PEPpuig/LSE/entregas/Controlador_BLDC_PepPuig_JordiGodas.docx

# CONTROLADOR BLDC

INDEX

1.INTRODUCCIÓ

A diferència dels motors DC tradicionals, on la commutació del corrent als bobinats del rotor es realitza mecànicament mitjançant escombretes, els motors BLDC (Brushless DC) estan formats per imants permanents al rotor, mentre que el bobinat es col·loca a l’estator distribuïts a 120º per un control trifàsic. Treure el component mecànic dels motors DC amb escombretes comporta una varietat d’avantatges:

- Una millor conversió d’energia. Passant d’una eficiència del 70-80% amb escombretes, a un 85-93%, degut a l’absència de fregament mecànic ens estalviem moltes de les pèrdues en calor.
- Millor durabilitat. Degut a la inexistència de desgast dels contactes mecànics, s’estén la vida útil del motor arribant a ser de 10 a 20 vegades més llarga.
- Reducció del soroll. Podent arribar a per sota de 50 decibels, 10 o 20 per sota dels altres.

Tot i això no tot són avantatges, ja que totes aquestes característiques venen al preu de major complexitat i preu, degut al necessari controlador de potència per a manegar el seu ús.

Per a controlar el BLDC es necessària l’etapa de potència coneguda com a inversor de 3 semi ponts, organitzat per 6 MOSFETs de potència en 3 branques diferents que permeten subministrar el corrent demanat pel motor ràpidament. Aquest muntatge té una sèrie de punts a favor i encontra:

Avantatges:

- Permet controlar de manera independent i reversible la direcció del corrent a cada bobina de l’estator.
- És possible la regulació de la velocitat i força del motor mitjançant PWM.
- Facilita la circulació del corrent en els períodes en OFF a través dels díodes de recirculació dels MOSFETs.
- La mateixa estructura permet diversos controls per software, ja sigui per controls senzill com trapezoidal, o més avançats com el FOC.

Inconvenients:

- Si per error de programació o retard de commutació dos dels transistor en un mateix semi pont s’activen a la vegada, es produeix un curtcircuit (Shoot–through) entre VCC i GND que pot destruir els MOSFETs. És important implementar un temps mort en la senyal de control per evitar que això pugui succeir.
- Els transistors superiors (High-side) necessiten una tensió de porta més alta que la de la alimentació (VCC) per commutar, el que ens obliga a implementar un circuit de bootstrap, incrementant la complexitat del circuit.
- La commutació (PWM) d’alta freqüència de les portes produeix soroll que pot propagar-se cap a altres parts del circuit. És necessari un bon esquemàtic de la PCB que tingui aquest efecte en compte, o la placa no serà funcional.

Com ja hem mencionat en els avantatges, podem excitar el circuit de 6 semiponts de diferents formes, sempre augmentant la complexitat per aconseguir un millor resultat.

Excitació trapezoidal:

És el mètode més senzill. En cada una dels 6 passos del cicle elèctric només s’activen dues fases mentre la tercera queda flotant. Aquesta fase flotant ens serveix per mesurar la BEMF i detectar el pas per zero per saber quan cal fer el següent pas.

Sinusoidal:

A diferencia de l’anterior, en comptes d’injectar corrent continu per blocs, els tres semi ponts commuten mitjançant un PWM per simular 3 sinusoidals desfasades 120º. Aquest mètode permet un moviment molt més suaus, eliminant les vibracions entre passos del mètode anterior. A canvi, la complexitat dels càlculs dificulta el seguiment de l’ona.

Field Oriented Control (FOC):

En aquest sistema es calcula la posició exacta de l’imant a cada instant, i es divideix el corrent en dos components independents, una que fa girar el motor ( I_q ) i un altre que genera calor ( I_d ). S’intenta ajustar el sistema en temps real de tal forma que I_d sigui 0, i Iq depengui de la velocitat que li volem donar. D’aquesta manera sempre s’aplica l’angle d’eficiència màxima fins i tot a baixes velocitats.

Degut a que disposem d’un motor sense sensor, es necessàri detectar la força contra electromotriu per deduir la posició del rotor. Per fer-ho podem usar diferents tècniques:

- Detecció de creuament per zero. Si usem la topologia trapezoidal, s’usa la fase que queda flotant per trobar el punt on BEMF passa a 0, en aquest punt és on hem de realitzar el canvi de fase. Per fer això possible, és necessari crear un node neutre virtual ja que el punt neutre real és inaccessible dintre del motor. Si no es dimensiona correctament el filtre passa-baix, el motor pot no arrencar.
- Mesura diferencial amb ADC. És mostreja la fase flotant amb un canal ADC sincronitzat amb els períodes ON i OFF del PWM, realitzant la comparació amb el neutre.
- Integració de BEMF. S’integra en el temps el senyal BEMF per determinar el flux magnètic acumulat. Requereix d’una capacitat de càlcul superior, a canvi d’una major immunitat al soroll.

Després de la introducció tecnològica descrita anteriorment, l’objectiu principal d’aquest projecte és la implementació en PCB i la programació d’un controlador electrònic de velocitat (ESC) sense sensors per a un motor BLDC. Per aconseguir l’èxit en aquesta tasca dividirem el projecte en diferents objectius més petits i específics:

Simulació:

- Correcte funcionament del model funcional del motor (BLDC) ajuntant les equacions del domini elèctric i mecànic.
- Analitzar el comportament del driver de potència IR2301SPBF, dels transistors MOSFET en configuració trifàsica, i el dimensionament del condensador de bootstrap.
- Simular el circuit de recuperació del senyal BEMF per tal de comparar-la amb l’original i observar l’absència de retards.

Disseny de la PCB

- Disseny correcte de l’esquemàtic estructurat amb blocs per funcionalitat.
- Layout de 4 capes separant les diferents parts de potència i lògica, assegurant el correcte funcionament quan s’imprimeixi.

Programació de la TIVA-C

- Programació dels PWM a 20kHz i la màquina d’estats de commutació de 6 estats.
- Implementar algoritme d’arrancada per vèncer la inèrcia inicial del motor.
- Programa per detectar el creuament de BEMF per zero i fer el funcionament del motor en close loop.

# 2. SIMULACIONS LTSPICE OPEN-LOOP

## 2.1 Model motor


Figura 1- Esquemàtic del model funcional del motor

El model funcional del motor és divideix en quatre segments, sent la primera d’elles el domini elèctric. En aquesta secció es modela la connexió en estrella de les tres fases (FASE_x) convergint en el node neutre, on cada branca inclou la inductància del bobinat (Lm), les pèrdues resistives associades ( R_m ) i la força de tensió contraelectromotriu ( V_(BEMF_x) ) representada com una font de tensió controlada en sèrie. Les 3 fases (A, B i C) provindran dels drivers (fora del model del motor) i la definició de les forces electromotrius, del subcircuit BEMF. Aquesta secció ens serveix per trobar el corrent de cada fase i així poder calcular la potència elèctrica que es transfereix a la part mecànica.

El següent apartat és la conversió de domini elèctric a mecànic, on és calcula en cada instant la potència elèctrica instantània. Per calcular-la sumem el resultat de la potència individual de les tres fases, la qual és igual a la força BEMF de cada fase referència al neutral multiplicada per la corrent corresponent. A partir de la igualtat entre la potència elèctrica i mecànica i utilitzant la freqüència angular, podem obtenir la força o parell mecànic del motor ( T_(motor) ).

P_(electrica_inst) =P_(mecànica) =T_(motor) *w →T_(motor) =(P_(electrica_(inst)))/w

La tercera secció és el domini mecànic on directament s’aplica la 2a llei de Newton per a un sistema rotatori:

T_(motor) -T_(load) =J*(dw)/(dt)+B*w → w=1/J(∫ (T_(motor) -T_(load) )dt-B∫ w*dt)

On T_(load) és la força externa que s’oposa al gir del motor; J és el moment d’inèrcia ( 10^(-6) kg*m^2 ) i B el coeficient de fricció viscos (2*10^(-3) (N*m*s)/(rad)) .

Mitjançat blocs integradors multiplicador podem aïllar la velocitat angular a través de la força del motor que hem trobat a l’apartat anterior. Fent el factor de conversió adequat podem passar rad/s a rpm per fer-nos una millor idea de la velocitat del motor. En aquest apartat també calculem l’angle total del gir del motor (theta_t) i la posició angular en una revolució, és a dir, de 0 a 2 π ; el primer integrant la velocitat angular en el temps i el segon mitjançant la funció següent en una font de tensió depenent:

V_(theta) ={(V_(theta_t))/(2π)-floor((V_(theta_t))/(2π))}*2π

La primera part de la funció ( (V_(theta_t))/(2π) ) calcula les voltes totals, i en restar-li la funció floor de la mateixa part, la cual retorna el nombre enter més proper, trobem la fracció de volta actual. Finalment al multiplicar per 2π ho passem a radians, i trobem l’angle actual del motor.

La última secció és la conversió de domini mecànic a elèctric, on usem la velocitat angular i l’angle total del motor per calcular les forces contraelectromotrius de cada branca ( V_(BEMF_x) ) i la tensió del neutre. Concretament l’angle total el multipliquem per 6 abans d’entrar al subcircuit BEMF degut a que 6 cicles elèctrics equivalen a una rotació sencera del motor. Amb aquests dos paràmetres dintre del subcircuit definim 3 donts de tensió dependents que definiran les BEMFs, generant senyals sinusoidals desfasades 120º amb amplitud KT * w.

V_(BEMF_x) =K_T *w*sin(θ_t +(2π)/3*i)

On i és 0 per la fase A, 1 per la B, i 2 per la C; K_T (constant de parell) expressa la força que produeix el motor per cada amper de corrent = 15*10^(-3) (N*m)/A

Per calcular els senyals de sensor hall (HALL_x)s’avalua la diferència de tensió entre fases mitjançant funcions if, donant 5V quan és positiva i 0 quan negativa.

## 2.2 Llaç obert

Per fer girar el motor l'alimentem amb tres fases desfasades 120º, generades per un inversor de tres semi ponts. L'esquemàtic complet de la simulació es pot veure a la Figura 2. El mòdul de generació de senyals crea les entrades dels drivers (HxI per al MOSFET alt i LxI per al baix de cada fase), on l'entrada alta es multiplica per un PWM de 20 kHz que ens permet regular la velocitat. Els drivers LTC4446, amb el seu circuit de bootstrap, exciten els MOSFETs IRFHM830D que alimenten el model del motor de l'apartat anterior. Fem servir els valors de l'exemple del curs: durada de fase de 1,2 ms, duty de 0,6, VCC = 10 V i parell de càrrega de 10 mN·m.


Figura 2- Esquemàtic que afegim al model del motor per simular el llaç obert


Figura 3a i 3b- Entrades (hxi i lxi) i sortides (fase_x) dels drivers per les 3 fases – Zoom de les entrades i sortides del driver de la fase A

A les Figures 3a i 3b podem veure el desfasament de 120º entre els senyals de control i la presència del PWM a l'entrada alta de cada driver. A la sortida es conserva aquest desfasament: cada fase està connectada a VCC amb el PWM durant dos estats, a massa durant dos més i queda flotant els dos restants, que és on apareix la BEMF que farem servir per detectar la posició del rotor.

La tensió del node neutre segueix el PWM i oscil·la entre 0 i uns 6,8 V a 20 kHz (Figura 10, a la secció 2.3, on es compara amb el neutre virtual). Aquest soroll és el que haurem de filtrar per poder comparar la BEMF amb el neutre.

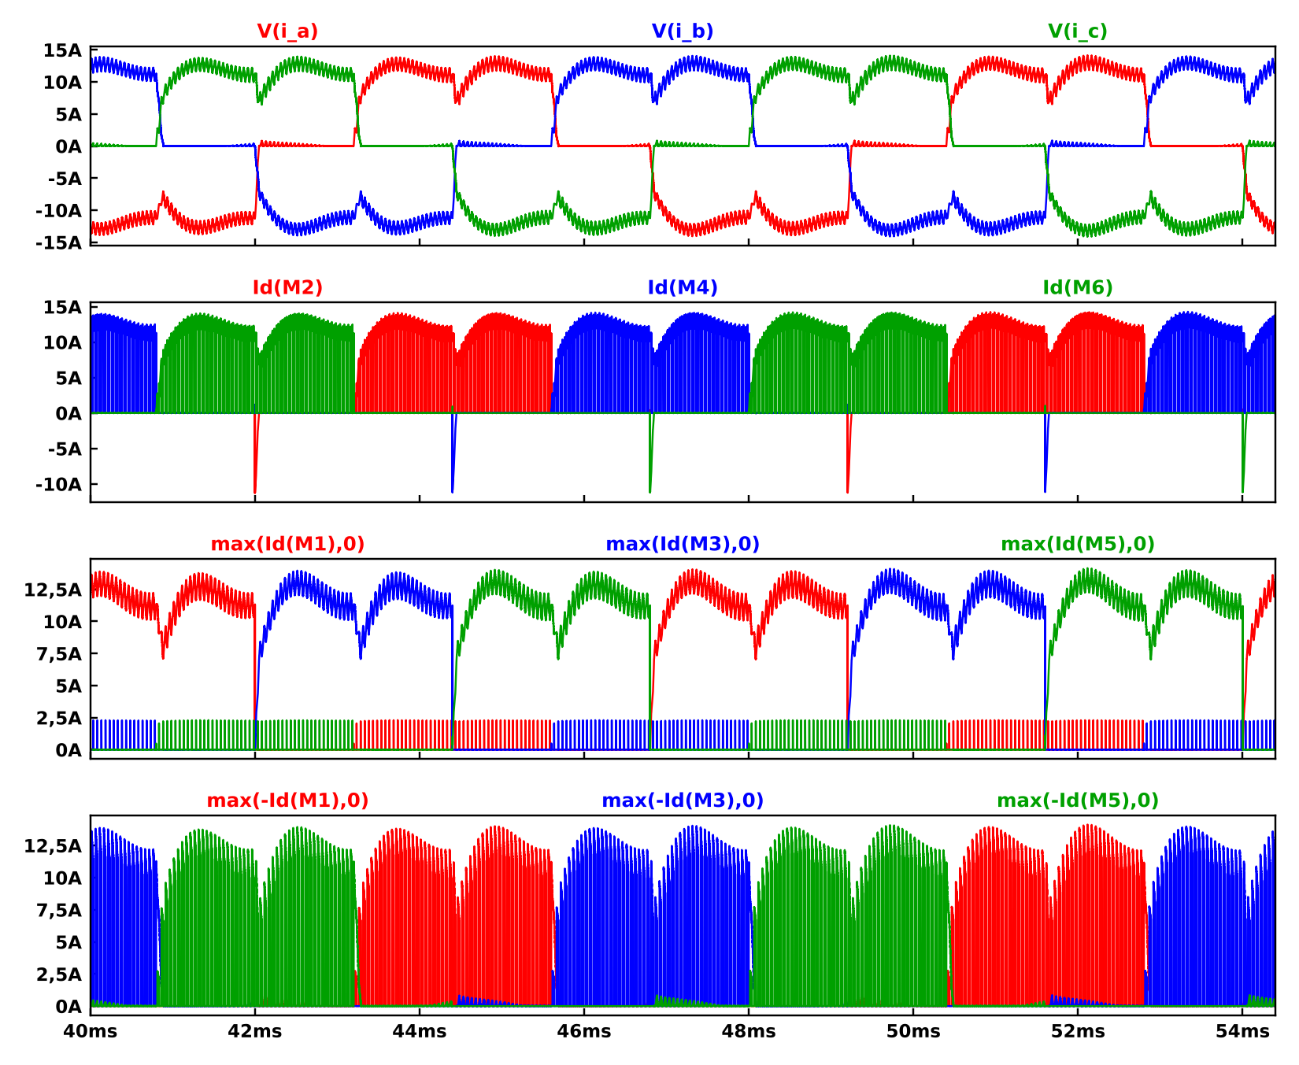
[picture p15: figure]

Figura 4- Corrents interns amb duty 0,6: bobinats (primer), MOSFETs alts (segon), MOSFETs baixos quan condueix el canal (tercer) i díodes de recirculació, part negativa del corrent dels MOSFETs baixos (quart)

La Figura 4 mostra els corrents interns del sistema. Els corrents dels bobinats mantenen la naturalesa trifàsica de l’excitació: estan desfasats 120º, presenten l'arrissat del PWM i en cada interval dues fases condueixen mentre la tercera queda lliure. El pic arriba als 14,2 A, amb 9,7 A eficaços per fase. Els MOSFETs alts només condueixen durant el temps en ON del PWM, en els dos estats en què la seva fase està connectada a VCC. Els MOSFETs baixos porten el corrent de retorn de manera contínua durant els dos estats en què la seva fase està a massa. Durant l'OFF del PWM, el corrent del bobinat, que no es pot interrompre de cop, recircula pel díode intern del MOSFET baix de la mateixa fase: els díodes condueixen polsos de fins a 12,4 A amb la mateixa envolupant que el corrent del MOSFET alt.

Quan l'entrada hai passa a 0, el driver descarrega la porta del MOSFET alt i la fase cau fins a −0,6 V, la caiguda del díode intern del MOSFET baix, que condueix amb la porta apagada (lai = 0). Quan hai torna a 1, el MOSFET alt recupera el corrent i el díode es bloqueja amb un petit pic de recuperació inversa. L'arrissat del corrent del bobinat és d'uns 2,5 A pic a pic, entre 10,0 i 12,4 A.

Cada flanc de la fase també indueix a la porta del MOSFET baix, que està apagat, un pic d'1,55 V a través de la capacitat porta-drenador. Queda per sota del llindar típic de l'IRFHM830D (VGS(th) = 1,8 V), però a prop del mínim (1,35 V), i és un dels motius per no reduir més la resistència de porta (secció 4.1).

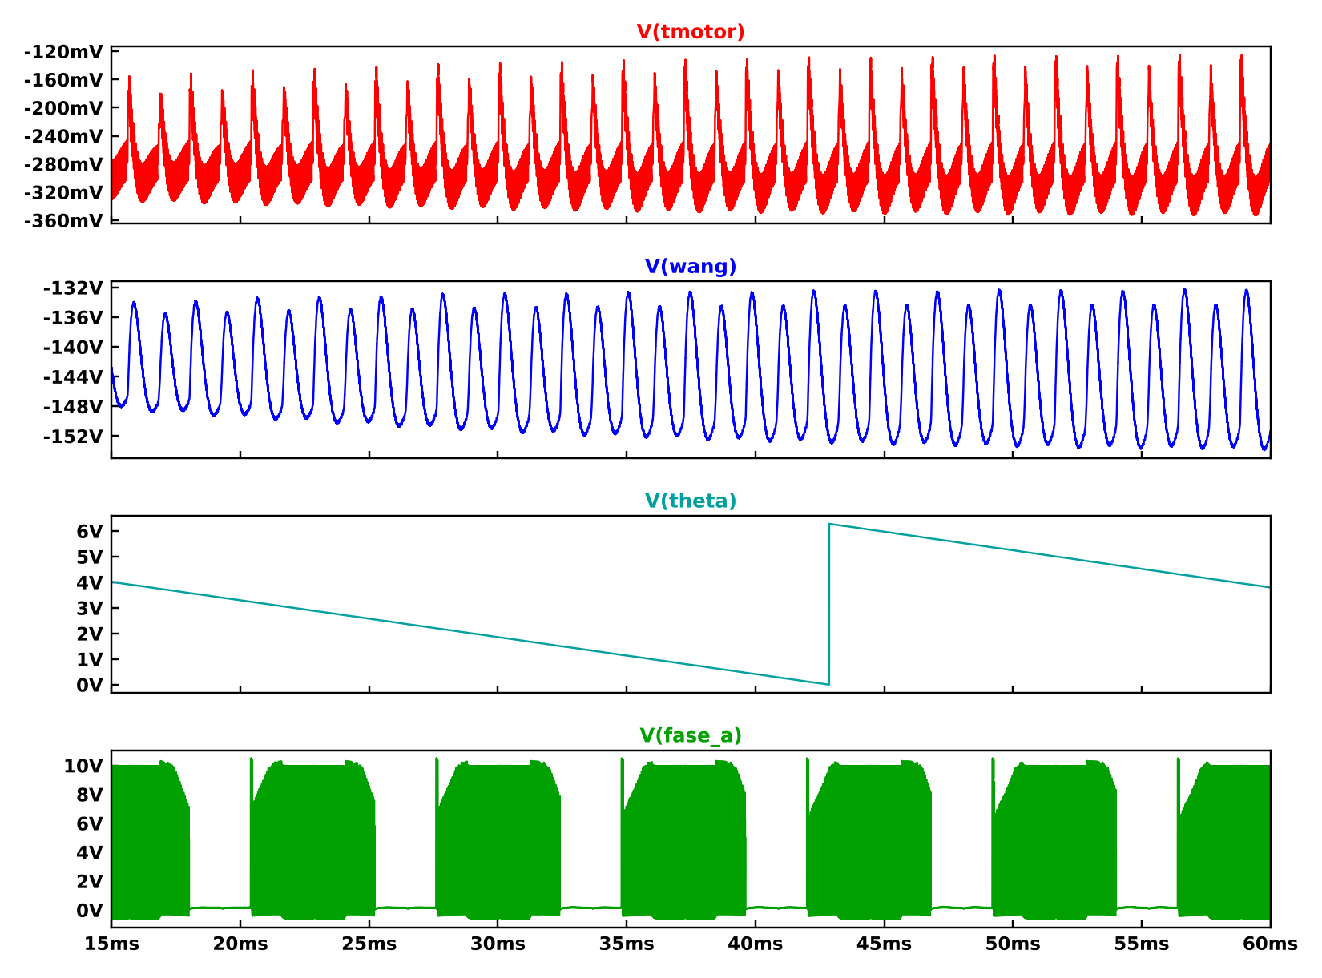
[picture p16: figure]

Figura 5- Parell del motor, velocitat angular, angle de gir acotat i tensió de la fase A en règim permanent amb duty 0,6

La Figura 5 mostra el parell, la velocitat angular i l'angle de gir acotat juntament amb la tensió de la fase A. L'angle es mostra com una rampa lineal que es reinicia a cada volta, uns 43 ms, temps en què la fase A fa sis cicles, ja que 6 cicles elèctrics equivalen a una rotació del motor. El parell presenta una oscil·lació a cada canvi d'estat, degut a la naturalesa commutada de l'alimentació, però el seu valor mitjà es manté estable en −0,28 N·m. La velocitat angular evoluciona de manera molt més suau, ja que la inèrcia del rotor filtra aquestes ondulacions, i es manté al voltant de −145 rad/s (1386 rpm), que és just la velocitat que imposa una durada de fase de 1,2 ms. El signe negatiu només indica el sentit de gir.

Per veure l'efecte del duty sobre el consum repetim la simulació amb diferents valors i calculem la potència mitjana i de pic de cada component (Taula 1).

Component | Duty 0,2 | Duty 0,4 | Duty 0,6 | Duty 0,8 | Duty 0,9
MOSFET alt [W] | 0,02 / 99 | 0,14 / 196 | 0,15 / 142 | 1,27 / 402 | 2,03 / 480
MOSFET baix [W] | 0,72 / 51 | 1,55 / 145 | 0,98 / 102 | 2,59 / 365 | 2,79 / 434
Driver [W] | 0,01 / 0,8 | 0,01 / 1,8 | 0,01 / 0,8 | 0,01 / 10,6 | 0,01 / 12,5

Taula 1- Consum dels components de potència segons el valor del duty (mitjana / pic)

Amb duty 0,2 i 0,4 el motor no té prou tensió per seguir la seqüència i no arrenca. A partir de 0,6 gira a la velocitat que marca la durada de fase, per tant augmentar el duty només fa créixer el corrent (fins a 31 A eficaços amb 0,9) i les pèrdues als MOSFETs, que passen d'1,1 W a 4,8 W de mitjana entre tots dos. Per això en llaç obert convé treballar amb un duty proper a 0,6.

Dissipació al driver i als MOSFETs. La Figura 6 mostra la potència instantània del driver i dels dos MOSFETs de la fase A amb duty 0,6. El driver LTC4446 dissipa uns 10 mW de mitjana, amb pics de 0,8 W només als flancs, perquè l'energia de porta per commutació és petita (Qg·VCC ≈ 27 nC · 10 V = 0,27 µJ). El MOSFET alt té pics de 140 W, però només durant les transicions, i una potència mitjana de 0,15 W. El MOSFET baix dissipa més, 0,98 W de mitjana: el pic de 100 W correspon a la recuperació del díode quan s'encén el MOSFET alt, i la major part de la potència és la conducció del díode intern durant l'OFF del PWM, perquè VSD·I és molt més gran que RDS(on)·I².

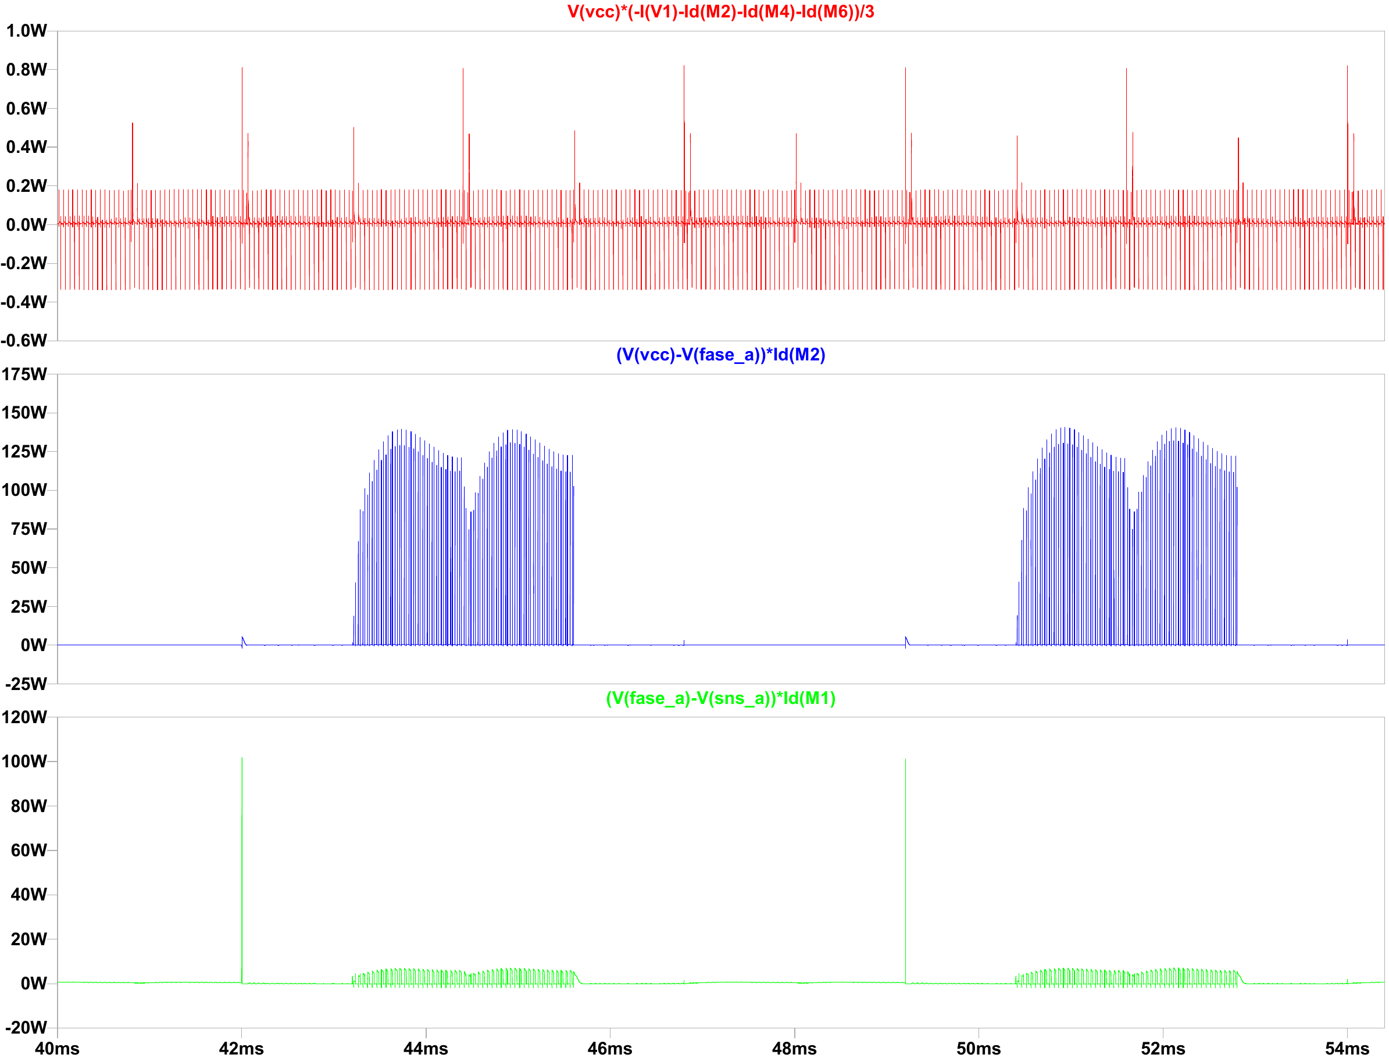
[picture p17: figure]

Figura 6- Potència instantània del driver (superior), del MOSFET alt M2 (intermedi) i del MOSFET baix M1 (inferior) de la fase A amb duty 0,6

Temps ON i OFF i efecte Miller. A la simulació, amb Rg = 33 Ω. En l'encesa, el driver triga uns 25 ns a respondre (retard de propagació) i la porta puja fins al plateau de Miller, a 3,2 V. Mentre la fase puja de −0,6 V a 10 V, la tensió de porta queda aturada uns 25 ns, perquè tot el corrent del driver carrega la capacitat porta-drenador. En l'apagada passa el contrari: la porta ha de baixar primer de 9,7 V fins al plateau (2,9 V), i aquest tram, que depèn de Rg·Ciss, fa que el retard d'apagada sigui molt més llarg que el d'encesa. La durada del plateau es pot estimar amb la càrrega porta-drenador del full de dades (Qgd = 4,5 nC) i la resistència interna de porta (RG,int = 1,1 Ω):

t_(pl,on) ≈(Q_(gd) (R_g +R_(G,int) ))/(V_(DRV) −V_(pl))=(4,5 nC⋅34 Ω)/(9,7 V−3,2 V)≈24 ns

t_(pl,off) ≈(Q_(gd) (R_g +R_(G,int) ))/(V_(pl))=(4,5 nC⋅34 Ω)/(2,9 V)≈53 ns

Els valors estimats coincideixen amb els 25 i 45 ns simulats. El nivell del plateau depèn del corrent commutat, ja que

V_(pl) =V_(th) +(I_D)/(g_(fs))

Amb més corrent el plateau puja: l'encesa es fa una mica més lenta (menys diferència entre la tensió del driver i Vpl) i l'apagada una mica més ràpida. La Taula 2 ho comprova amb l'escombrat de duty, en què el corrent commutat passa de 4 a 36 A de mitjana: el temps de pujada de la fase va de 19,1 a 21,2 ns i el de baixada de 44,1 a 41,7 ns. En tot el rang, tON ≈ 66 ns (46 ns de retard més 20 ns de pujada) i tOFF ≈ 160 ns (120 ns de retard més 41 ns de baixada), molt per sota del període del PWM (50 µs). La taula inclou també la temperatura de la unió estimada a partir de la potència mitjana de la Taula 1 i de la resistència tèrmica unió-ambient de l'IRFHM830D (RθJA = 46 °C/W, Ta = 25 °C):

T_j =T_a +P R_(θJA)

Duty | I commutat (mitjana / màx.) | tr fase (10–90 %) | tf fase (90–10 %) | Pin | Tj MOSFET alt | Tj MOSFET baix
0,2 | 3,8 / 7,8 A | 19,1 ns | 44,1 ns | 10,1 W | 26 °C | 58 °C
0,4 | 9,4 / 17,3 A | 19,7 ns | 42,6 ns | 43,5 W | 31 °C | 96 °C
0,6 | 10,7 / 12,0 A | 19,5 ns | 42,7 ns | 67,5 W | 32 °C | 70 °C
0,8 | 28,1 / 37,4 A | 21,0 ns | 41,3 ns | 215,9 W | 83 °C | 144 °C
0,9 | 35,3 / 45,0 A | 21,2 ns | 41,7 ns | 297,1 W | 118 °C | 153 °C

Taula 2- Temps de commutació de la fase A, corrent commutat, potència d'entrada i temperatura de la unió estimada segons el duty (estats d'1,2 ms)

Verificació del SOA. Hem comparat la trajectòria (VDS, ID) dels dos MOSFETs al llarg de les simulacions amb duty 0,6 i 0,9, amb els límits absoluts de l'IRFHM830D. La tensió no supera 11 V (VDS,màx = 30 V). El corrent arriba a 14 A amb duty 0,6 i a 47,6 A amb duty 0,9; aquest darrer valor supera el corrent continu (40 A, limitat per l'encapsulat), però queda lluny del corrent de pols (IDM = 160 A). Els punts amb tensió i corrent alts alhora només apareixen durant les transicions, de menys de 50 ns, molt més curtes que el pols més curt de la corba SOA del full de dades (100 µs). Per tant, el límit real no és el SOA sinó la temperatura: el MOSFET baix arriba a uns 144 °C amb duty 0,8 i a 153 °C amb duty 0,9 (Taula 2), per sobre dels 150 °C admissibles, mentre que amb duty 0,6 tots dos queden per sota de 70 °C.


Figura 7- Corrent del díode de bootstrap (superior), corrent del condensador de bootstrap (intermedi) i tensió del bootstrap (inferior)

Pel que fa al bootstrap (Figura 7), el díode només condueix mentre la fase A està connectada a massa, amb un pic inicial i polsos curts a cada període del PWM, que és quan el condensador es recarrega. Quan la fase passa a VCC el condensador alimenta el driver del MOSFET alt i la seva tensió baixa lentament, però es manté entre 9,7 i 10,5 V, per tant el MOSFET alt sempre té prou tensió de porta per commutar.

També hem simulat el cas amb Cboot = 220 nF. La tensió VBS es manté entre 9,70 i 10,53 V, pràcticament igual que amb 1 µF (9,73–10,49 V), però el pic de recàrrega del díode puja de 0,15 A a 1,18 A, perquè el condensador perd més càrrega mentre la fase està flotant o connectada a VCC. En aquesta topologia el condensador es recarrega a cada OFF del PWM, quan el díode intern del MOSFET baix porta la fase a −0,6 V (Figura 4), i també durant els dos estats en què la fase està connectada a massa. La caiguda per període del PWM és petita:

ΔV_(BS) =(Q_g +I_(BOOST) /f_(PWM))/(C_(boot))=(27 nC+0,1 nC)/(1 μF)≈27 mV

Rang de freqüència i de duty del PWM. Combinant els temps de commutació (punt 3) i el bootstrap (punt 4) obtenim els límits següents:

- Duty. Cada pols ha de durar més que una encesa i una apagada completes, tON + tOFF ≈ 0,23 µs, i l'OFF ha de ser prou llarg perquè el díode del MOSFET baix porti la fase a massa. A 20 kHz:

D_(min) ≈(t_(ON) +t_(OFF) ) f_(PWM) ≈0,5 %  D_(max) ≈1−(t_(ON) +t_(OFF) ) f_(PWM) ≈99,5 %

- Amb D = 1 el bootstrap ha d'aguantar dos estats sense recàrrega (2,4 ms); amb el consum de la banda alta del driver (≤ 2 µA) la caiguda és inferior a 5 mV amb 1 µF, de manera que el bootstrap no limita el duty.
- Freqüència màxima. Les pèrdues de commutació i de porta creixen proporcionalment a fPWM. Si volem que les transicions ocupin menys de l'1 % del període:

f_(PWM) ≤(0,01)/(t_(ON) +t_(OFF))=(0,01)/(0,23 μs)≈43 kHz

- Freqüència mínima. L'arrissat del corrent ha de ser petit davant del corrent de fase. Amb dues fases en sèrie (2Lm = 60 µH):

ΔI_(pp) ≈(V_(CC) D (1−D))/(2 L_m f_(PWM))=(10 V⋅0,6⋅0,4)/(60 μH⋅20 kHz)=2,0 A

que coincideix amb els 2,5 A simulats (Figura 4) i representa un 20 % del corrent de fase. Per sota de 20 kHz l'arrissat creix i el soroll de commutació entra a la banda audible. Per tant, el PWM pot treballar aproximadament entre 20 i 40 kHz, i triem 20 kHz. Pel que fa al duty, el rang elèctric és 0,5–99,5 %, però amb estats d'1,2 ms el motor només segueix la seqüència a partir de D ≈ 0,6, i amb D = 0,8 el MOSFET baix ja arriba a 144 °C. En llaç obert el rang útil és, doncs, D ≈ 0,6–0,7.

Per completar l'anàlisi en llaç obert fem les quatre simulacions proposades a classe, que només canvien la durada de fase, el duty i la capacitat de bypass (Taula 3). La velocitat esperada és la que marca la seqüència, 60 / (36 · Tfase), ja que una volta del rotor són 6 períodes elèctrics de 6 estats cadascun. Els valors mitjans estan presos en règim permanent.

Simulació | Durada de fase | Duty | Cbypass | Velocitat esperada | Velocitat mitjana | Parell mitjà | IA eficaç
1 | 1,2 ms | 0,6 | 33 nF | 1389 rpm | −1389 rpm | −0,281 N·m | 9,6 A
2 | 1,2 ms | 0,2 | 33 nF | 1389 rpm | −123 rpm | −0,015 N·m | 4,7 A
3 | 5 ms | 0,2 | 33 nF | 333 rpm | −333 rpm | −0,060 N·m | 5,3 A
4 | 1,5 ms | 0,58 | 150 nF | 1111 rpm | −1111 rpm | −0,223 N·m | 16,5 A

Taula 3- Paràmetres i resultats de les quatre simulacions en llaç obert

Les simulacions 2 i 3 mostren l'efecte d'un duty baix. Amb duty 0,2 i fases de 1,2 ms el motor no té prou parell per seguir la seqüència i queda bloquejat (stall): l'angle pràcticament no avança i la velocitat oscil·la entre −459 i +437 rpm. Amb el mateix duty però fases de 5 ms el motor sí que segueix la seqüència, a 333 rpm. Per tant, amb poca tensió el motor pot girar si la seqüència és prou lenta, i per això l'arrencada es fa amb una durada de fase llarga que es va reduint.

A la simulació 1 es comprova que una rotació completa del rotor són 6 períodes elèctrics de la fase A. Tot i que la BEMF del model és sinusoidal amb l'angle, en llaç obert pren una forma trapezoidal, perquè la seva amplitud KT·ω segueix l'oscil·lació de la velocitat a cada canvi d'estat, la mateixa vibració que es veu al parell de la Figura 5. La BEMF recuperada està pràcticament en fase amb la real: el comparador canvia d'estat 0,27 ms després del pas per zero real (13º elèctrics).

A la simulació 4 augmentem Cbypass a 150 nF. El motor gira a 1111 rpm, però la BEMF recuperada queda clarament endarrerida: el comparador canvia 1,6 ms després del pas per zero real (64º elèctrics). Uns 0,96 ms d'aquest retard els introdueix el filtre RC, ja que la constant de temps passa a ser de 1,3 ms, i la resta es deu a que el pas per zero real cau quan la fase A encara està connectada pel driver. Si el retard s'acostés als 90º el motor perdria el pas, i per això Cbypass no pot ser gaire gran (apartat 2.3).

BEMF de cada bobinat. Finalment, la Figura 8 comprova que el model genera la BEMF de les tres fases. Les tres tensions respecte al neutre tenen la mateixa amplitud, 2,20 V, que coincideix amb KT·ω = 0,015 · 145,2 = 2,18 V, i els seus passos per zero estan separats 2,41 ms, un terç del període elèctric de 7,22 ms (120°). La forma no és una sinusoide perfecta perquè l'amplitud segueix les oscil·lacions de la velocitat a cada canvi d'estat. Els senyals hall del model canvien cada 60° elèctrics, en els creuaments entre parelles de BEMF, i reprodueixen la seqüència de sis estats.

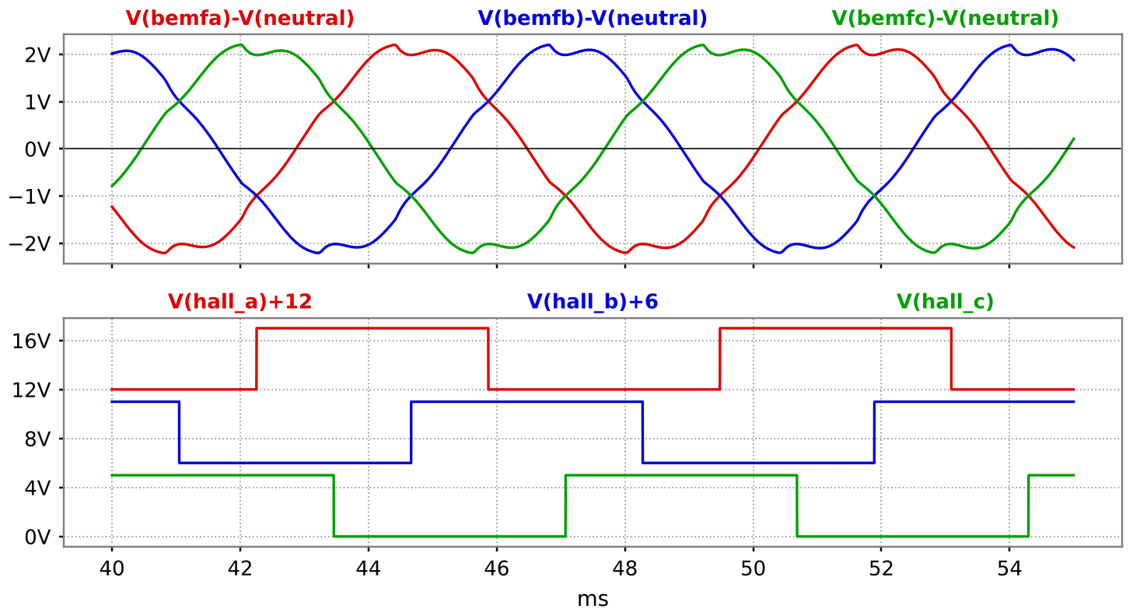
[picture p18: figure]

Figura 8- BEMF de les tres fases respecte al neutre (superior) i senyals hall del model (inferior, desplaçats verticalment) en règim permanent amb duty 0,6

## 2.3 Detecció BEMF


Figura 9- Esquemàtic que afegim al model open loop per extreure la BEMF

Per poder controlar el motor en llaç tancat necessitem conèixer la posició del rotor. Com que no disposem de sensors hall, la deduïm del pas per zero de la BEMF de la fase flotant. Per mesurar-la necessitem la tensió de cada fase, a la qual tenim accés directe, i la del node neutre, que queda dins del motor. Per això el bloc d'extracció BEMF de la Figura 9 crea un neutre virtual amb una estrella de tres resistències iguals, ja que VN = (VA + VB + VC) / 3. A la Figura 10 podem veure que el neutre virtual és pràcticament idèntic al real, amb una diferència de valor mitjà de només 23 mV.

Després, un divisor de tensió (33 kΩ i 12 kΩ) adequa les senyals de fase i de neutre per sota dels 3,3 V que accepta el microcontrolador, i una capacitat de bypass en paral·lel forma un filtre RC de primer ordre que elimina el soroll del PWM. A la Figura 11 comparem la BEMF real amb la recuperada: la senyal filtrada manté la forma i els passos per zero de l'original, amb una amplitud de ±0,86 V.


Figura 10 i 11- Neutre real (superior) vs neutre virtual (inferior) – BEMF_A real (superior) vs BEMF_A filtrada (inferior)


Figura 12- BEMF_B real (superior), BEMF_B filtrada (intermedi) i sortida del comparador B (inferior)

Finalment, el comparador dona un 1 quan la BEMF filtrada és positiva i un 0 quan és negativa (Figura 12), i cada flanc marca el pas per zero que farà servir el microcontrolador per fer el següent canvi d'estat. El filtre introdueix un retard respecte al pas per zero real que depèn de la capacitat de bypass. Amb un anàlisi paramètric entre 1 i 150 nF hem vist que amb valors petits el PWM no queda filtrat i el comparador rebota, mentre que amb valors grans el retard creix fins a gairebé 39º elèctrics amb 150 nF. Amb els 33 nF de la simulació el retard és d'uns 13º, i amb 22 nF baixa a uns 8º sense deixar passar el soroll del PWM. El valor definitiu de la placa i la compensació del retard es justifiquen a la secció 4.

# 3. DISSENY HARDWARE CONTROLADOR BLDC

Secció corresponent a la 2a entrega (revisió del disseny final): esquemàtic i disseny de la PCB.

# 4. SIMULACIONS LTSPICE CLOSE-LOOP

## 4.1 Selecció de components

La Taula 4 recull els components de la placa final, agrupats per funció. Els valors es calculen per a VCC = 12 V i el punt de treball del model del curs (1389 rpm, 12,1 A per estat), amb les dades dels fulls d'especificacions dels components. A continuació es resumeix la pauta de càlcul dels components que demana l'enunciat.

Bloc | Referència | Component / valor | Funció
Potència | MOSFET1–6 | IRFR1205 (55 V, 27 mΩ, DPAK) | Pont trifàsic
Drivers | IC4–IC6 | IR2301S | Driver alt i baix de cada fase
| RAH1…RCL1 / CAH1…CCL1 | 33 Ω / 100 pF | Filtre RC d'entrada
| RGAH1…RGCL1 | 33 Ω | Resistència de porta
Bootstrap | CA/CB/CC_BOOT1 | 1 µF ceràmic (≥ 25 V) | Condensador de bootstrap
| D2–D4 | 1N4149 | Díode de bootstrap
Desacoblament | CDES1 | 470 µF electrolític | Bulk de 12 V
| CADES1, CBDES1, CCDES1 | 10 µF | Alimentació dels drivers
| CADES2, CBDES2, CCDES2 | 100 nF | Drenadors (alta freqüència)
Detecció BEMF | RdivX2 / RdivX1 (X = A, B, C) | 33 kΩ / 10 kΩ | Divisor de fase
| Rstar_A1, B1, C1 | 1 kΩ | Neutre virtual
| Rdiv1 / Rdiv2 | 33 kΩ / 10 kΩ | Divisor del neutre
| Cb1–Cb3 | 33 nF | Filtre diferencial (bypass)
| Cgnd1–3, CDiv1 | 100 pF | Filtre de mode comú
Comparador | IC3 / CDESCOMP1 | LM339 a 5 V / 100 nF | Pas per zero / desacoblament
| RPull1–3 | 4,7 kΩ a 3,3 V | Pull-up de sortida
Alimentació | IC1, L1, D1, CBUCKDESO1 | AP1509-50, 47 µH, B240A, 470 µF | Buck 12 V → 5 V
| CBD1, CBD2 | 100 nF, 10 µF | Desacoblament d'entrada del buck
| IC2, CLDO1–2 | LMS8117-3.3, 10 µF tàntal | LDO 5 V → 3,3 V
| LED1, R1 | LED vermell, 1 kΩ | Indicador de 12 V
Consigna i control | RPOT1, CPOT1, CDP1 | 10 kΩ, 100 nF, 100 nF | Potenciòmetre i filtre
| U1, CDES2 | EK-TM4C123GXL, 10 µF | PWM de 20 kHz, ADC i GPIO

Taula 4- Components de la placa del controlador

Caracterització del motor. Abans de dimensionar els components hem mesurat les constants de temps del motor a l'arrencada de la simulació en llaç obert, amb el criteri del 63 % del valor final (Figura 13). La velocitat angular arriba al 63 % de la de règim (−91,9 de −145,4 rad/s) als 394 µs, i el corrent de la fase A arriba al 63 % del seu primer pic (11,8 de 18,6 A) als 158 µs. Són més curtes que J/B = 500 µs i Lm/Rm = 375 µs perquè la BEMF afegeix un esmorteïment elèctric (d'ordre KT²/Rm) i frena el creixement del corrent a mesura que el motor accelera. Totes dues són molt més llargues que el període del PWM (50 µs): per això el corrent i la velocitat només mostren un petit arrissat a 20 kHz.

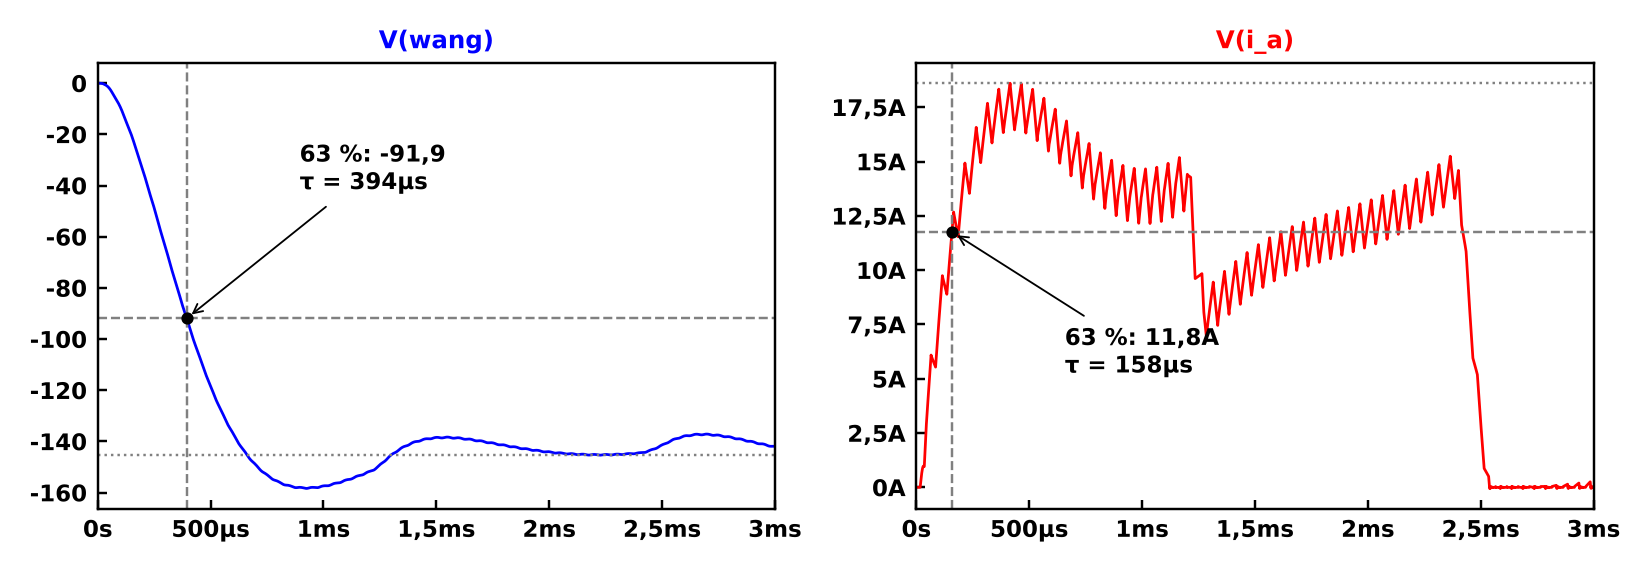
[picture p19: figure]

Figura 13- Constants de temps a l'arrencada en llaç obert: velocitat angular (esquerra) i corrent de la fase A (dreta), amb el punt del 63 %

Bootstrap. El condensador ha de cobrir dues situacions. A cada període del PWM ha d'aportar la càrrega de porta de l'IRFR1205 (Qg = 65 nC), el consum de l'IR2301 (IQBS = 100 µA) i la càrrega de desplaçament de nivell (Qls ≈ 5 nC), sense que VBS baixi de 9 V. Tenint en compte la caiguda del díode (VF ≈ 1 V) i la del MOSFET baix (VLS = 12,1 A · 40 mΩ = 0,49 V):

C_(boot) ≥(2(2Q_g +(I_(QBS))/(f_(PWM))+Q_(ls) ))/(V_(CC) −V_F −V_(LS) −V_(BS,min))=(2 (130+5+5) nC)/(12−1−0,49−9 V)=185 nF

El cas més exigent, però, és l'inici de la rampa d'arrencada, amb estats de 4 ms: el MOSFET alt pot quedar encès dos estats seguits (8 ms) sense que la fase torni a massa, i el condensador només es descarrega pel consum del driver:

ΔV=(Q_g +I_(QBS) t)/(C_(boot)) ⇒ t=8 ms: ΔV_(220 nF) =3,93 V, ΔV_(1 μF) =0,87 V

Amb 220 nF VBS baixaria fins a 6,6 V, i amb 1 µF es manté per sobre de 9,6 V; per això triem Cboot = 1 µF. La càrrega es fa a través del díode 1N4149 i del MOSFET baix, amb una constant de temps d'1 µs, i la descàrrega fins a 9 V triga uns 14 ms:

τ_c ≈C_(boot) (R_D +R_(DS(on)) )≈1 μF⋅1 Ω=1 μs

t_d =(C_(boot) ΔV_(max) −Q_g)/(I_(QBS))=(1 μF⋅1,51 V−65 nC)/(100 μA)≈14 ms

Abans d'arrencar convé encendre uns 10 µs els tres MOSFETs baixos per precarregar els condensadors. El díode 1N4149 suporta 100 V en inversa i el pic de recàrrega simulat (1,18 A amb 220 nF) queda per sota del seu IFSM (4 A).

Resistència de porta. Rg limita el corrent de porta, i amb ell la velocitat de commutació, les pèrdues i el soroll. Per a l'IR2301 (IO+ = 200 mA) i l'IRFR1205 (Qgd = 27 nC, Vpl ≈ 5 V), amb Rg = 33 Ω:

I_(G,on) =min((V_(CC) −V_(pl))/(R_g), I_(O+) )=min(0,21; 0,20)=0,20 A  I_(G,off) =(V_(pl))/(R_g)=0,15 A

t_(on) =(Q_(gd))/(I_(G,on))=135 ns  t_(off) =(Q_(gd))/(I_(G,off))=178 ns

El pendent de la fase resultant (12 V / 135 ns = 0,09 V/ns) és molt inferior al límit de l'IR2301 (50 V/ns). Per triar el valor vam escombrar Rg a la simulació (Taula 5): amb 10 Ω el pic de corrent de porta és de 0,70 A i els flancs de 7 ns augmenten el soroll i el pic induït a la porta del MOSFET baix (secció 2.2); amb 220 Ω l'energia per commutació es multiplica per nou. Amb 33 Ω les pèrdues són gairebé les de 10 Ω amb un pic de porta 2,7 vegades menor. La velocitat del motor no canvia. Davant de cada entrada del driver hi ha un filtre de 33 Ω i 100 pF (τ = 3,3 ns) que elimina els pics de nanosegons sense retardar el PWM.

Rg | Pujada | Baixada | Energia / commutació | IG pic | P MOSFET alt | Velocitat
10 Ω | 7 ns | 15 ns | 1,0 µJ | 0,70 A | 0,11 W | 1362 rpm
33 Ω | 19 ns | 40 ns | 2,5 µJ | 0,26 A | 0,12 W | 1364 rpm
100 Ω | 53 ns | 116 ns | 4,6 µJ | 0,09 A | 0,17 W | 1369 rpm
220 Ω | 118 ns | 247 ns | 9,5 µJ | 0,04 A | 0,27 W | 1380 rpm

Taula 5- Escombrat de la resistència de porta a la simulació (LTC4446, IRFHM830D, duty 0,6)

Desacoblament de l'alimentació del driver. El condensador d'alimentació de cada driver (CxDES1 = 10 µF) aporta la càrrega de porta del MOSFET baix i la recàrrega del bootstrap. Fem servir la regla habitual de les notes d'aplicació, almenys deu vegades Cboot:

ΔV_(CC) =(Q_g)/(C_(DES1))=(65 nC)/(10 μF)=6,5 mV  C_(DES1) ≥10 C_(boot) =10 μF

Al costat dels drenadors hi ha condensadors de 100 nF (CxDES2) que absorbeixen els flancs d'alta freqüència, i el bulk de 470 µF (CDES1) aporta el corrent mitjà del pont.

Resistències del node virtual i divisors. Els divisors redueixen la tensió de les fases i del neutre perquè quedi per sota de 3,3 V (entrada de la TIVA) i dins del rang de mode comú del LM339 alimentat a 5 V (fins a 3,5 V). Amb 33 kΩ / 10 kΩ:

k=(R_(div1))/(R_(div1) +R_(div2))=10/(33+10)=0,233  V_(max) =12⋅0,233=2,79 V

V_(pic) =(12+1,3)⋅0,233=3,09 V

El valor de pic correspon a la fase per sobre de VCC durant la lliure circulació (VSD = 1,3 V). Els divisors consumeixen 0,28 mA, i per això no carreguen les fases. El neutre virtual es forma amb tres resistències d'1 kΩ en estrella, prou petites davant del divisor del neutre perquè aquest no desequilibri l'estrella (error de 11 mV, equivalent a 1,2° en el pas per zero). En el pitjor cas, amb una fase a 12 V i les altres a massa:

V_N =(V_A +V_B +V_C)/3  P_(R_(star)) =((12−4)^2)/(1 kΩ)=64 mW

Resistència Thévenin i condensador de bypass. Cada condensador Cb està connectat entre la fase dividida i el neutre dividit i veu la resistència Thévenin del divisor. El filtre ha d'atenuar el PWM de 20 kHz i retardar poc la BEMF:

R_(th) =R_(div2) ∥R_(div1) =7,67 kΩ  τ=R_(th) C_b =253 μs  f_c =1/(2πτ)=628 Hz

1/(|H(20 kHz)|)=√(1+(2π⋅20 kHz⋅τ)^2)=31,8  φ=arctan(ω_e τ)=12,5^(∘) (1389 rpm)

El retard en temps és gairebé constant (0,25 ms), de manera que en graus creix amb la velocitat. Amb 33 nF queda per sota dels 30° fins a unes 3600 rpm; el motor real del projecte de referència gira entre 2700 i 11 400 rpm, de manera que el firmware haurà de compensar el retard (secció 4.2) o caldrà baixar Cb a 10 nF. Els condensadors de 100 pF a massa (Cgnd) eliminen els pics ràpids de mode comú:

τ_(gnd) =R_(th) C_(gnd) =7,67 kΩ⋅100 pF=0,77 μs  f_c =207 kHz

## 4.2 Verificació de l'anàlisi i funcionament en close-loop

Per tancar el llaç fem servir la simulació 08, el mòdul de generació de senyals de la qual es mostra a la Figura 14. Parteix de l'esquemàtic de llaç obert (Figures 2 i 9) amb els components de la Taula 4 (Cboot = 1 µF, divisors de 33 kΩ / 10 kΩ, Cbypass = 33 nF, Cgnd = 100 pF i Rg = 33 Ω) i hi afegeix dos elements al mòdul de generació de senyals:

- Una arrencada en rampa: la durada de l'estat baixa de 4 a 1,2 ms en 40 ms (fonts cnt i estat), amb duty 0,6.
- El bloc ESC_OLCL_TD (fitxer .sub), que fa de multiplexor. Mentre STEP = 0, les entrades dels drivers venen de les fonts de temps (llaç obert, equivalent als temporitzadors del microcontrolador). A t = 50 ms, STEP passa a 1 i les entrades es calculen amb la lògica dels comparadors, AH = A·B̄, AL = Ā·B, BH = B·C̄, BL = B̄·C, CH = C·Ā i CL = C̄·A, amb el PWM aplicat només a la banda alta.

Per commutar en el punt de màxim parell, la fase alta ha de conduir entre 30° i 150° després del pas per zero de la seva BEMF, centrada en el màxim. Els comparadors canvien en el pas per zero més el retard del filtre, de manera que, sense correcció, el bloc commuta uns 18° abans d'hora. Per això ESC_OLCL_TD retarda les sortides dels comparadors un temps Td:

T_d =(30^(∘) −φ)/(360^(∘)) T_e =(30^(∘) −12,5^(∘))/(360^(∘))⋅7,2 ms≈350 μs

Al microcontrolador aquest retard es calcularà a partir del temps entre passos per zero; a la simulació, amb la velocitat gairebé constant, n'hi ha prou amb un valor fix. Per simular-ho cal obrir 08_closed_loop_placa.asc amb BEMF.sub, ESC_OLCL_TD.sub i els seus símbols a la mateixa carpeta i executar l'anàlisi transitòria (.tran de 120 ms, mètode gear). La directiva .step param Td list 10u 350u fa dues simulacions, sense compensar (10 µs, retard negligible) i compensada, i les directives .meas donen la velocitat, el parell, el corrent eficaç i la potència d'entrada entre 90 i 120 ms.

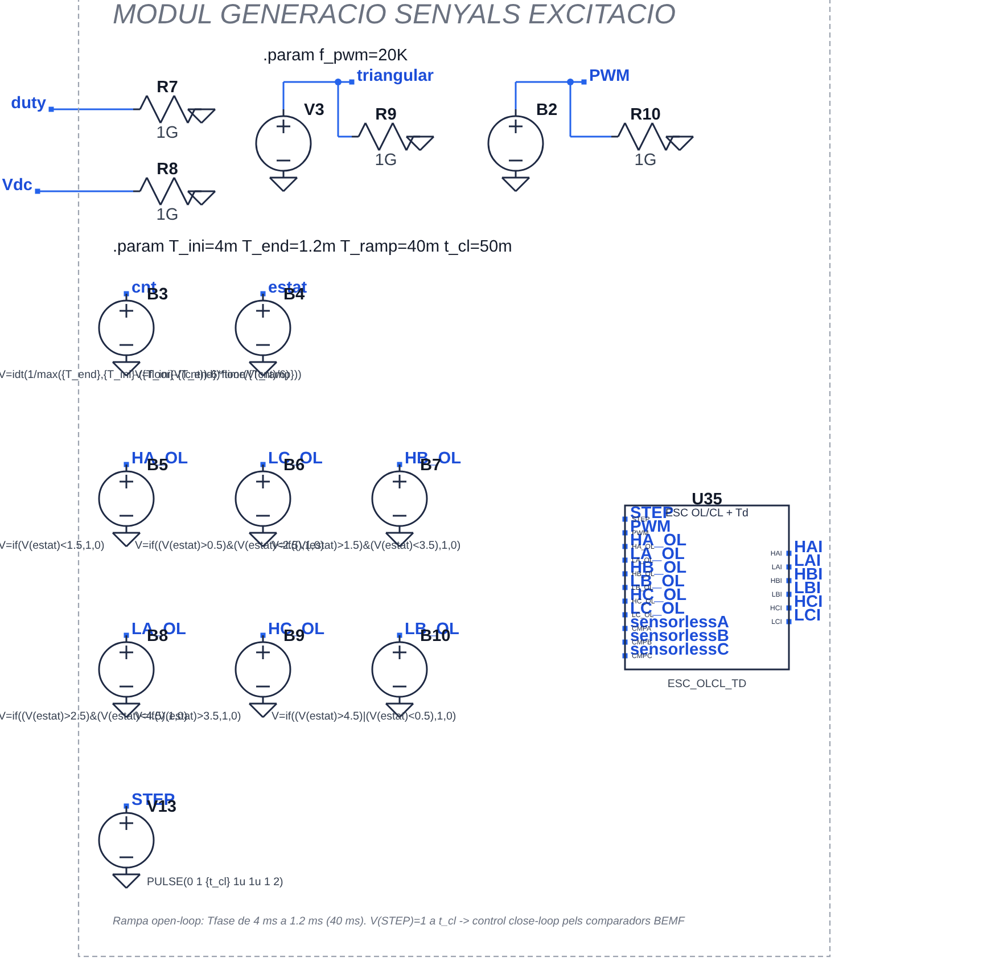
[picture p20: figure]

Figura 14- Mòdul de generació de senyals de la simulació en llaç tancat (08_closed_loop_placa.asc): arrencada en rampa, senyal STEP i bloc ESC_OLCL_TD. La resta de l'esquemàtic és el de les Figures 2 i 9 amb els components de la Taula 4

La Figura 15 mostra la simulació completa. Durant la rampa el rotor oscil·la i el corrent arriba a 33 A; a 50 ms el control passa als comparadors sense cap salt de velocitat, i el motor s'estabilitza en pocs períodes elèctrics. A partir d'aquest moment els estats ja no els marca el temporitzador: cada flanc d'un comparador, retardat Td, inicia l'estat següent. Per exemple, la fase A s'encén amb PWM quan sensorlessA = 1 i sensorlessB = 0.

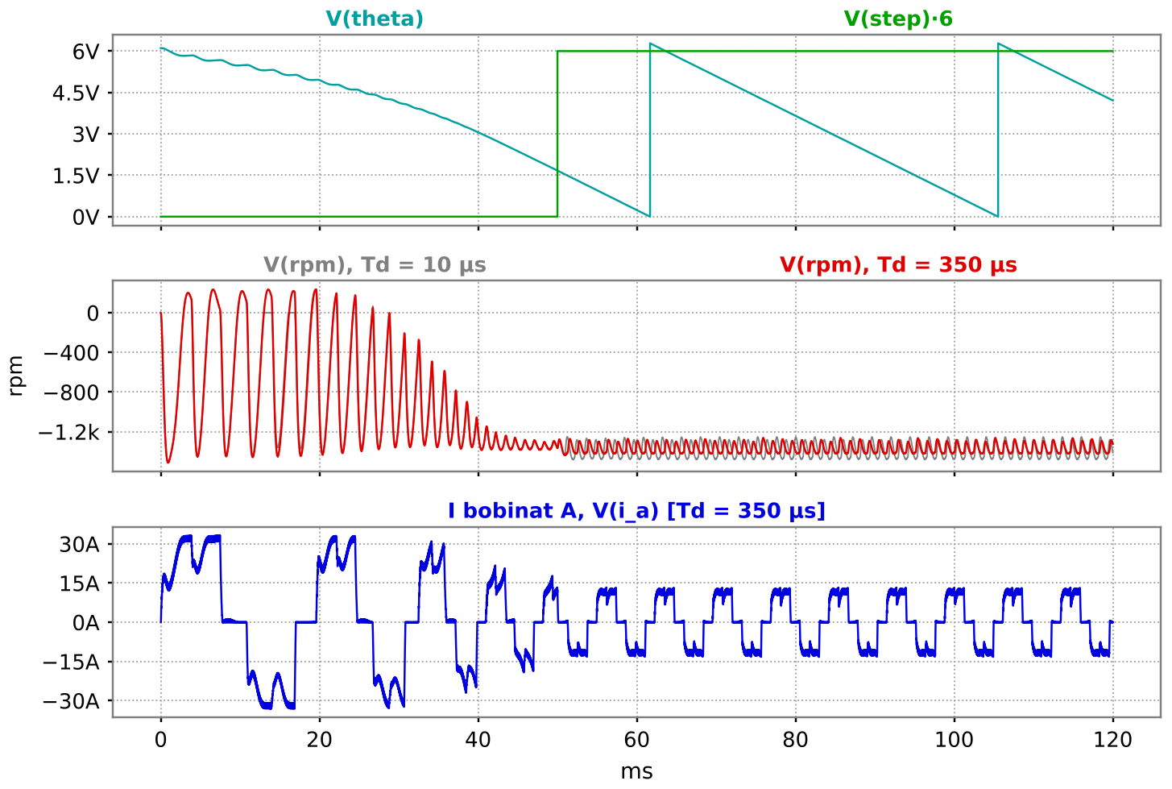
[picture p21: figure]

Figura 15- Simulació en llaç tancat: angle del rotor i senyal STEP (superior), velocitat amb Td = 10 µs i 350 µs (intermedi) i corrent del bobinat A amb Td = 350 µs (inferior)

La Figura 16 mostra on cau la conducció de la fase A respecte a la seva BEMF. Sense compensar, la fase alta condueix entre 12° i 132°: el comparador canvia 11,3° després del pas per zero real, prop dels 12,5° calculats a la secció 4.1. Amb Td = 350 µs condueix entre 28° i 148°, pràcticament centrada en el màxim de la BEMF. La Taula 6 recull els resultats en règim permanent: amb la mateixa càrrega, el corrent eficaç baixa un 5 %, la potència d'entrada un 6 % i el parell per ampere puja un 4 %. La velocitat baixa lleugerament, de 1389 a 1367 rpm, perquè la commutació avançada actua com un avançament de fase, que augmenta la velocitat a costa del rendiment. El bootstrap d'1 µF manté VBS ≥ 9,72 V en tots dos casos. Com a referència, la simulació 07, amb els valors provats inicialment (Cboot = 220 nF i Cbypass = 22 nF) i sense compensar, commuta encara més d'hora, perquè el filtre de 22 nF només retarda 7,8°: la fase condueix entre 8° i 128° i el corrent eficaç puja a 10,06 A.

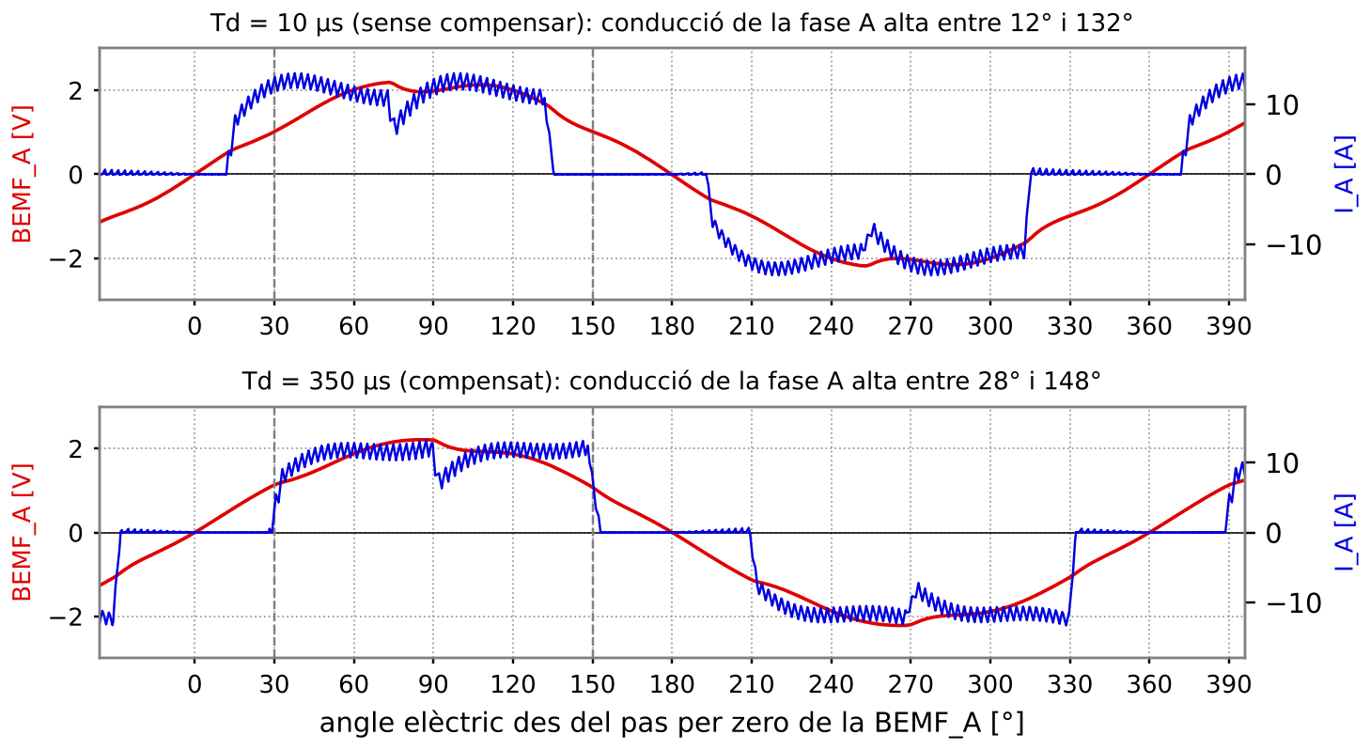
[picture p22: figure]

Figura 16- BEMF i corrent del bobinat A en funció de l'angle elèctric, sense compensar (Td = 10 µs, superior) i compensat (Td = 350 µs, inferior)

Magnitud (90–120 ms) | Sim. 07 (220 nF, 22 nF) | Sim. 08, Td = 10 µs | Sim. 08, Td = 350 µs
Velocitat mitjana | 1402 rpm | 1389 rpm | 1367 rpm
Parell mitjà | 0,283 N·m | 0,281 N·m | 0,276 N·m
IA eficaç / pic | 10,06 / 15,2 A | 9,59 / 14,5 A | 9,08 / 13,3 A
Potència d'entrada | 71,1 W | 68,6 W | 64,4 W
Parell per ampere | 28,1 mN·m/A | 29,3 mN·m/A | 30,4 mN·m/A
Retard del comparador | 7,8° | 11,3° | 10,8°
Conducció de la fase A alta | 8°–128° | 12°–132° | 28°–148°
VBS mínima | – | 9,72 V | 9,72 V

Taula 6- Resultats en règim permanent de les simulacions en llaç tancat (valors absoluts; el signe negatiu del model només indica el sentit de gir)

Per a la lògica de transició i la rampa hem seguit les transparències del curs (Departament d'Enginyeria Electrònica i Biomèdica, s.f.) i les notes d'aplicació de Texas Instruments (Akin & Bhardwaj, 2015) i NXP (Prokop & Chalupa, 2005); els valors dels components surten dels fulls d'especificacions citats a la bibliografia.

# Bibliografia

Akin, B., & Bhardwaj, M. (2015). Sensorless Trapezoidal Control of BLDC Motors (SPRABQ7A). Obtenido de Texas Instruments: https://www.ti.com/lit/an/sprabq7a/sprabq7a.pdf

Alonso, M. (Abril de 2022). Obtenido de Youtube: https://www.youtube.com/watch?v=UDR9EBPJxGg

Analog Devices. (s.f.). LTspice. Obtenido de https://www.analog.com/en/resources/design-tools-and-calculators/ltspice-simulator.html

Departament d'Enginyeria Electrònica i Biomèdica. (s.f.). Control trapezoidal motor BLDC: arrencada en rampa i transició a close-loop. Laboratori de Sistemes Electrònics I, Universitat de Barcelona.

Departament d'Enginyeria Electrònica i Biomèdica. (s.f.). Modelat d'un motor BLDC. Laboratori de Sistemes Electrònics I, Universitat de Barcelona.

ElektorLabs. (2026). Designing Reliable Sensorless BLDC Controllers. Obtenido de https://www.elektormagazine.com/labs/designing-reliable-sensorless-bldc-controllers

Diodes Incorporated. (s.f.). AP1509: 150 kHz, 2 A PWM Buck DC/DC Converter. Obtenido de https://www.pericom.com/assets/App-Note-Files/power/sw_reg/ANP013_1509.pdf

Gómez Cama, J. M., & Sieiro, J. (s.f.). Control de velocitat electrònic sense sensors per a motors BLDC. Laboratori de Sistemes Electrònics I, Universitat de Barcelona.

IC-Online. (10 de Agost de 2026). Brush Motor vs Brushless Motor Engineering Trade-offs Across Modern Electronics. Obtenido de https://www.ic-online.com/blog/post/brush-motor-vs-brushless-motor-trade-offs-guide

Infineon Technologies. (s.f.). IR2301(S) High and Low Side Driver. Obtenido de https://www.infineon.com/assets/row/public/documents/24/49/infineon-ir2301s-datasheet-en.pdf

Infineon Technologies. (s.f.). IRFHM830D - N-channel MOSFET. Obtenido de https://www.infineon.com/part/IRFHM830D

International Rectifier. (s.f.). IRFR1205 / IRFU1205 HEXFET Power MOSFET. Obtenido de https://chipfind.net/datasheet/html/irf/irfr1205.html

Linear Technology. (2008). LTC4446: High Voltage High Side/Low Side N-Channel MOSFET Driver. Obtenido de Analog Devices: https://www.analog.com/media/en/technical-documentation/data-sheets/4446f.pdf

Martínez, A., & Sirvent, A. (2026). Memòria Tècnica - Motor BLDC. Laboratori de Sistemes Electrònics I, Universitat de Barcelona.

Microchip Technology. (s.f.). How Sensorless Brushless DC (BLDC) Motors Work. Obtenido de Microchip Developer Help: https://developerhelp.microchip.com/xwiki/bin/view/applications/motors/control-algorithms/bldc/sensorless/

onsemi. (s.f.). 1N4149 Small Signal Diode. Obtenido de https://www.onsemi.com/pdf/datasheet/1n4149-d.pdf

Prokop, L., & Chalupa, L. (2005). 3-phase BLDC Motor Control with Sensorless Back-EMF ADC Zero Crossing Detection using 56F80x (AN1913). Obtenido de Freescale Semiconductor: https://www.nxp.com/docs/en/application-note/AN1913.pdf

STMicroelectronics. (2007). Sensorless BLDC motor control and BEMF sampling methods with ST7MC (AN1946). Obtenido de https://www.st.com/resource/en/application_note/cd00020086-sensorless-bldc-motor-control-and-bemf-sampling-methods-with--st7mc-stmicroelectronics.pdf

Texas Instruments. (s.f.). LMS8117A 1-A Low-Dropout Linear Regulator. Obtenido de https://www.ti.com/document-viewer/LMS8117A/datasheet

Texas Instruments. (s.f.). LM339 Quad Differential Comparators. Obtenido de https://www.ti.com/lit/ds/symlink/lm339.pdf

Vishay General Semiconductor. (2020). 1N5817, 1N5818, 1N5819 Schottky Barrier Plastic Rectifier. Obtenido de https://www.vishay.com/docs/88525/1n5817.pdf

Jordi Godàs Pep Puig 20/09/2026 Laboratori de Sistemes Electrònics 1
