PEPpuig/LSE/Controlador_BLDC/Models/AP1509-50SG-13/3D/AP1509-50SG-13.stp

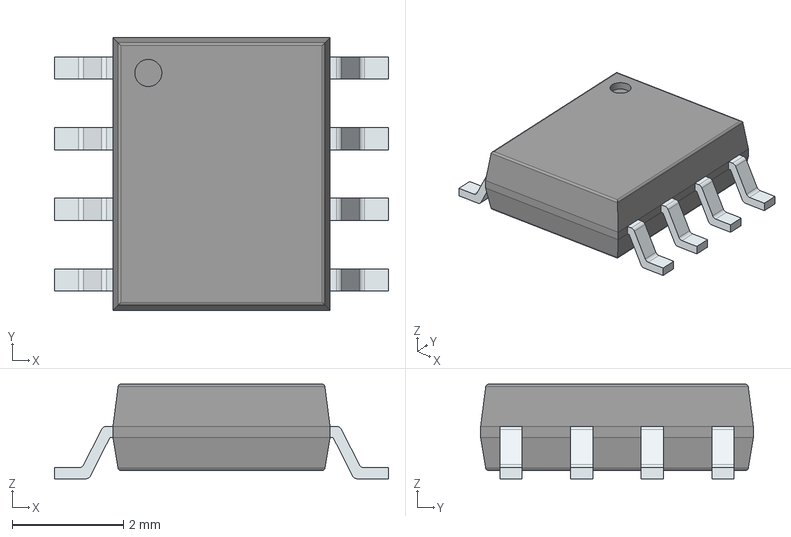
[picture p68: CAD file, 2026-09-30]
Controlador_BLDC/Models/AP1509-50SG-13/3D/AP1509-50SG-13.stp
6.00 x 4.90 x 1.70 mm
PinsArrayLR
