PEPpuig/LSE/(list of files, cad)

Other CAD files:
Controlador_BLDC/Models/AP1509-50SG-13/Allegro/soic127p600x170-8n.psm
Controlador_BLDC/Models/AP1509-50SG-13/DEHDL/ap1509_50sg_13/chips/chips.prt
