PEPpuig/LSE/simulacions/close_loop_model.asc

A1: inv
A2: inv
A3: inv
A4: inv
A5: inv
A6: inv
A7: inv
R1: res; 1k
R2: res; 9k
R3: res; 1k
R4: res; 9k
R5: res; 1k
R6: res; 9k
R7: res; 1k
R8: res; 9k
R9: res; 1k
R10: res; 9k
R11: res; 1k
R12: res; 9k
U1: mul
U2: mul
U3: mul
U4: mul
U5: mul
U6: mul
U7: mul
U8: mul
U9: mul
U10: mul
U11: mul
U12: mul
U13: mul
U14: mul
U15: mul
U16: mul
U17: mul
U18: mul
U19: mul
U20: mul
U21: mul
U22: mul
U23: mul
U24: mul
U25: adder2
U26: adder2
U27: adder2
U28: adder2
U29: adder2
U30: adder2
U31: comp; Vlow=0
U32: comp; Vlow=0
U33: comp; Vlow=0
Named nets: AH_OL, AL_OL, BH_OL, BL_OL, CH_OL, CL_OL, 0, cmpA, cmpB, cmpC, S_CL, S_OL, HAI_OL, LAI_OL, HBI_OL, LBI_OL, HCI_OL, LCI_OL, HAI, LAI, HBI, LBI, HCI, LCI, sensA, sensB, sensC
.tran 5
