PEPpuig/LSE/simulacions/01_OL_base.asc

B1: bv; V={ (V(theta_t) / (2*pi) - floor(V(theta_t) / (2*pi)) ) * 2*pi }
B2: bv; V={V(Vdc) * if(V(triangular) < V(duty), 1, 0)}
C1: cap; {C_boot}
C2: cap; {C_boot}
C3: cap; {C_boot}
C4: cap; {Cgnd}
C5: cap; {Cbypass}
C6: cap; {Cgnd}
C7: cap; {Cgnd}
C8: cap; {Cbypass}
C9: cap; {Cgnd}
C10: cap; {Cbypass}
D1: schottky; 1N5818
D2: schottky; 1N5818
D3: schottky; 1N5818
L1: ind; {Lm}; Rser={Rm}
L2: ind; {Lm}; Rser={Rm}
L3: ind; {Lm}; Rser={Rm}
M1: nmos; IRFHM830D
M2: nmos; IRFHM830D
M3: nmos; IRFHM830D
M4: nmos; IRFHM830D
M5: nmos; IRFHM830D
M6: nmos; IRFHM830D
R1: res; 1Meg
R2: res; 1G
R3: res; 1G
R4: res; 1G
R5: res; 1G
R6: res; {Rg}
R7: res; 1G
R8: res; 1G
R9: res; 1G
R10: res; 1G
R11: res; 1G
R12: res; 1G
R13: res; 1G
R14: res; 1G
R15: res; 1G
R16: res; 1G
R17: res; {Rg}
R18: res; {Rsense}
R19: res; {R_in}
R20: res; {R_in}
R21: res; {Rg}
R22: res; {Rg}
R23: res; {Rsense}
R24: res; {R_in}
R25: res; {R_in}
R26: res; {Rg}
R27: res; {Rg}
R28: res; {Rsense}
R29: res; {R_in}
R30: res; {R_in}
R31: res; {Rstar}
R32: res; {Rstar}
R33: res; {Rstar}
R34: res; {RdivH}
R35: res; {RdivL}
R36: res; {RdivH}
R37: res; {RdivL}
R38: res; {RdivH}
R39: res; {RdivL}
R40: res; {RdivH}
R41: res; {RdivL}
U1: BEMF; KT=15e-3
U2: isense
U3: isense
U4: isense
U5: sub2
U6: sub2
U7: mul
U8: mul
U9: sub2
U10: mul
U11: adder3
U12: div
U13: sub2
U14: div; eps=0
U15: constant; K={J}
U16: integ; ic={B/J*theta0}
U17: sub2
U18: constant; K={B/J}
U19: mul
U20: integ; ic={theta0}
U21: gain; A={60 / (2*pi)}
U22: mul
U23: mul
U24: mul
U25: mul
U26: mul
U27: mul
U28: LTC4446
U29: LTC4446
U30: LTC4446
U31: gain; A=6
U32: comp
U33: comp
U34: comp
V1: voltage; 10
V2: voltage; 1e-2
V3: voltage; PULSE(0 1 0 {1/(2*f_pwm)} {1/(2*f_pwm)} 0 {1/f_pwm})
V5: voltage; 3.3
V6: voltage; {duty}
V7: voltage; PULSE(0 1 0 1u 1u {2*state_period} {6*state_period})
V8: voltage; PULSE(0 1 {3*state_period} 1u 1u {2*state_period} {6*state_period})
V9: voltage; PULSE(0 1 {2*state_period} 1u 1u {2*state_period} {6*state_period})
V10: voltage; PULSE(1 0 {state_period} 1u 1u {4*state_period} {6*state_period})
V11: voltage; PULSE(0 1 {4*state_period} 1u 1u {2*state_period} {6*state_period})
V12: voltage; PULSE(0 1 {1*state_period} 1u 1u {2*state_period} {6*state_period})
Named nets: FASE_A, FASE_B, FASE_C, 0, Neutral, HALL_C, HALL_B, HALL_A, BEMFA, I_A, I_B, I_C, BEMFB, BEMFC, Pe_inst, wang, Tmotor, theta_t, Tload, rpm, theta, duty, triangular, Vdc, PWM, HA, HAI, LA, LAI, HB, HBI, LB, LBI, HC, HCI, LC, LCI, VCC, N_virtual, N_virtual_div, BEMF_A_rec, BEMF_B_rec, BEMF_C_rec, sensorlessA, sensorlessB, sensorlessC, SNS_A, GH_A, GL_A, GH_B, GL_B, GH_C, GL_C, SNS_B, SNS_C, BOOT_A, BOOT_B, BOOT_C
.param Lm=30u Rm=0.08
Conversio de domini 
electric a mecanic
--> Tmotor = Pe_inst / w
Pe_inst = Pmec
Domini electric
Conversio de domini 
mecanic a electric
.param J=1e-6 B=2e-3
Domini mecanic
Mesures
2ona llei Newton --> 
--> w = 1/J int(Tmotor-Tload, dt) - B/J int(w,dt)
MODEL FUNCIONAL MOTOR
DRIVERS DE POTENCIA
EXTRACCIO BEMF
MODUL GENERACIO SENYALS EXCITACIO
.tran 0 {Tsim} 0 startup
.param f_pwm=20K
.param state_period=1.2m
.param R_in=33 Rg=33 C_boot=1000n Rsense=1e-2
.param Rstar=1K RdivH=33K RdivL=12K Cbypass=33n Cgnd=1p
SIM 01 - LLAC OBERT BASE (valors exemple del curs)
Tfase=1.2ms  duty=0.6  fpwm=20kHz  Tload=10 mN.m  Cbypass=33n
.param duty=0.6
.param Tsim=60m T1=40m
.param theta0={-pi/18}
.options method=gear
.meas TRAN rpm_avg AVG V(rpm) FROM {T1} TO {Tsim}
.meas TRAN rpm_max MAX V(rpm) FROM {T1} TO {Tsim}
.meas TRAN rpm_min MIN V(rpm) FROM {T1} TO {Tsim}
.meas TRAN w_avg AVG V(wang) FROM {T1} TO {Tsim}
.meas TRAN Tm_avg AVG V(Tmotor) FROM {T1} TO {Tsim}
.meas TRAN Tm_max MAX V(Tmotor) FROM {T1} TO {Tsim}
.meas TRAN Tm_min MIN V(Tmotor) FROM {T1} TO {Tsim}
.meas TRAN IA_rms RMS V(I_A) FROM {T1} TO {Tsim}
.meas TRAN IA_pk MAX abs(V(I_A)) FROM {T1} TO {Tsim}
.meas TRAN PMH_avg AVG (V(VCC)-V(FASE_A))*Id(M2) FROM {T1} TO {Tsim}
.meas TRAN PMH_max MAX (V(VCC)-V(FASE_A))*Id(M2) FROM {T1} TO {Tsim}
.meas TRAN PML_avg AVG (V(FASE_A)-V(SNS_A))*Id(M1) FROM {T1} TO {Tsim}
.meas TRAN PML_max MAX (V(FASE_A)-V(SNS_A))*Id(M1) FROM {T1} TO {Tsim}
.meas TRAN PMH_max_all MAX (V(VCC)-V(FASE_A))*Id(M2)
.meas TRAN PML_max_all MAX (V(FASE_A)-V(SNS_A))*Id(M1)
.meas TRAN IdH_max MAX Id(M2) FROM {T1} TO {Tsim}
.meas TRAN IdL_min MIN Id(M1) FROM {T1} TO {Tsim}
.meas TRAN IdL_max MAX Id(M1) FROM {T1} TO {Tsim}
.meas TRAN ID1_max MAX I(D1) FROM {T1} TO {Tsim}
.meas TRAN ID1_avg AVG I(D1) FROM {T1} TO {Tsim}
.meas TRAN IC1_max MAX I(C1) FROM {T1} TO {Tsim}
.meas TRAN IC1_min MIN I(C1) FROM {T1} TO {Tsim}
.meas TRAN Vboot_min MIN V(BOOT_A)-V(FASE_A) FROM {T1} TO {Tsim}
.meas TRAN Vboot_max MAX V(BOOT_A)-V(FASE_A) FROM {T1} TO {Tsim}
.meas TRAN Vboot_avg AVG V(BOOT_A)-V(FASE_A) FROM {T1} TO {Tsim}
.meas TRAN Ivcc_avg AVG -I(V1) FROM {T1} TO {Tsim}
.meas TRAN Pin_avg AVG -V(VCC)*I(V1) FROM {T1} TO {Tsim}
.meas TRAN Pdrv_avg AVG V(VCC)*(-I(V1)-Id(M2)-Id(M4)-Id(M6))/3 FROM {T1} TO {Tsim}
.meas TRAN Pdrv_max MAX V(VCC)*(-I(V1)-Id(M2)-Id(M4)-Id(M6))/3 FROM {T1} TO {Tsim}
.save V(hai) V(lai) V(hbi) V(lbi) V(hci) V(lci) V(pwm) V(triangular) V(ha) V(la) V(hb) V(lb) V(hc) V(lc)
.save V(fase_a) V(fase_b) V(fase_c) V(neutral) V(bemfa) V(bemfb) V(bemfc)
.save V(i_a) V(i_b) V(i_c) V(tmotor) V(wang) V(rpm) V(theta) V(theta_t) V(pe_inst) V(tload)
.save V(vcc) I(V1) V(sns_a) V(sns_b) V(sns_c) Id(M1) Id(M2) Id(M3) Id(M4) Id(M5) Id(M6)
.save I(D1) I(D2) I(D3) I(C1) I(C2) I(C3) V(boot_a) V(boot_b) V(boot_c)
.save V(gh_a) V(gl_a) I(R6) I(R17) I(R18) I(R23) I(R28)
.save V(n_virtual) V(n_virtual_div) V(bemf_a_rec) V(bemf_b_rec) V(bemf_c_rec) V(sensorlessa) V(sensorlessb) V(sensorlessc)
.save V(hall_a) V(hall_b) V(hall_c)
