PEPpuig/LSE/simulacions/07_closed_loop.asc

B1: bv; V={ (V(theta_t) / (2*pi) - floor(V(theta_t) / (2*pi)) ) * 2*pi }
B2: bv; V={V(Vdc) * if(V(triangular) < V(duty), 1, 0)}
B3: bv; V=idt(1/max({T_end},{T_ini}-({T_ini}-{T_end})*time/{T_ramp}))
B4: bv; V=floor(V(cnt))-6*floor(V(cnt)/6)
B5: bv; V=if(V(estat)<1.5,1,0)
B6: bv; V=if((V(estat)>0.5)&(V(estat)<2.5),1,0)
B7: bv; V=if((V(estat)>1.5)&(V(estat)<3.5),1,0)
B8: bv; V=if((V(estat)>2.5)&(V(estat)<4.5),1,0)
B9: bv; V=if(V(estat)>3.5,1,0)
B10: bv; V=if((V(estat)>4.5)|(V(estat)<0.5),1,0)
C1: cap; {C_boot}
C2: cap; {C_boot}
C3: cap; {C_boot}
C4: cap; {Cgnd}
C5: cap; {Cbypass}
C6: cap; {Cgnd}
C7: cap; {Cgnd}
C8: cap; {Cbypass}
C9: cap; {Cgnd}
C10: cap; {Cbypass}
D1: schottky; 1N5818
D2: schottky; 1N5818
D3: schottky; 1N5818
L1: ind; {Lm}; Rser={Rm}
L2: ind; {Lm}; Rser={Rm}
L3: ind; {Lm}; Rser={Rm}
M1: nmos; IRFHM830D
M2: nmos; IRFHM830D
M3: nmos; IRFHM830D
M4: nmos; IRFHM830D
M5: nmos; IRFHM830D
M6: nmos; IRFHM830D
R1: res; 1Meg
R2: res; 1G
R3: res; 1G
R4: res; 1G
R5: res; 1G
R6: res; {Rg}
R7: res; 1G
R8: res; 1G
R9: res; 1G
R10: res; 1G
R17: res; {RgL}
R18: res; {Rsense}
R19: res; {R_in}
R20: res; {R_in}
R21: res; {Rg}
R22: res; {RgL}
R23: res; {Rsense}
R24: res; {R_in}
R25: res; {R_in}
R26: res; {Rg}
R27: res; {RgL}
R28: res; {Rsense}
R29: res; {R_in}
R30: res; {R_in}
R31: res; {Rstar}
R32: res; {Rstar}
R33: res; {Rstar}
R34: res; {RdivH}
R35: res; {RdivL}
R36: res; {RdivH}
R37: res; {RdivL}
R38: res; {RdivH}
R39: res; {RdivL}
R40: res; {RdivH}
R41: res; {RdivL}
U1: BEMF; KT=15e-3
U2: isense
U3: isense
U4: isense
U5: sub2
U6: sub2
U7: mul
U8: mul
U9: sub2
U10: mul
U11: adder3
U12: div
U13: sub2
U14: div; eps=0
U15: constant; K={J}
U16: integ; ic={B/J*theta0}
U17: sub2
U18: constant; K={B/J}
U19: mul
U20: integ; ic={theta0}
U21: gain; A={60 / (2*pi)}
U28: LTC4446
U29: LTC4446
U30: LTC4446
U31: gain; A=6
U32: comp
U33: comp
U34: comp
U35: ESC_OLCL; VL=3.3 mode={mode}
V1: voltage; 10
V2: voltage; 1e-2
V3: voltage; PULSE(0 1 0 {1/(2*f_pwm)} {1/(2*f_pwm)} 0 {1/f_pwm})
V5: voltage; 3.3
V6: voltage; {duty}
V13: voltage; PULSE(0 1 {t_cl} 1u 1u 1 2)
Named nets: FASE_A, FASE_B, FASE_C, 0, Neutral, HALL_C, HALL_B, HALL_A, BEMFA, I_A, I_B, I_C, BEMFB, BEMFC, Pe_inst, wang, Tmotor, theta_t, Tload, rpm, theta, duty, triangular, Vdc, PWM, VCC, HAI, LAI, HBI, LBI, HCI, LCI, N_virtual, N_virtual_div, BEMF_A_rec, BEMF_B_rec, BEMF_C_rec, sensorlessA, sensorlessB, sensorlessC, SNS_A, GH_A, GL_A, GH_B, GL_B, GH_C, GL_C, SNS_B, SNS_C, BOOT_A, BOOT_B, BOOT_C, cnt, estat, HA_OL, LC_OL, HB_OL, LA_OL, HC_OL, LB_OL, STEP
.param Lm=30u Rm=0.08
Conversio de domini 
electric a mecanic
--> Tmotor = Pe_inst / w
Pe_inst = Pmec
Domini electric
Conversio de domini 
mecanic a electric
.param J=1e-6 B=2e-3
Domini mecanic
Mesures
2ona llei Newton --> 
--> w = 1/J int(Tmotor-Tload, dt) - B/J int(w,dt)
MODEL FUNCIONAL MOTOR
DRIVERS DE POTENCIA
EXTRACCIO BEMF
MODUL GENERACIO SENYALS EXCITACIO
.tran 0 {Tsim} 0 startup
.param f_pwm=20K
.param R_in=33 Rg={RgH} C_boot=220n Rsense=1e-2
.param Rstar=1K RdivH=33K RdivL=10K Cbypass=22n Cgnd=1p
.param T_ini=4m T_end=1.2m T_ramp=40m t_cl=50m
Rampa open-loop: Tfase de 4 ms a 1.2 ms (40 ms). V(STEP)=1 a t_cl -> control close-loop pels comparadors BEMF
SIM 07 - ARRENCADA EN RAMPA OPEN-LOOP I TRANSICIO A CLOSE-LOOP (valors de disseny)
modul ESC_OLCL.sub: STEP=0 -> fonts de temps (OL);  STEP=1 -> logica dels comparadors (CL)
.param duty=0.6 RgH=33 RgL=33 mode=0
.param Tsim=120m T1=90m
.param theta0={-pi/18}
.options method=gear
.meas TRAN rpm_avg AVG V(rpm) FROM {T1} TO {Tsim}
.meas TRAN rpm_max MAX V(rpm) FROM {T1} TO {Tsim}
.meas TRAN rpm_min MIN V(rpm) FROM {T1} TO {Tsim}
.meas TRAN w_avg AVG V(wang) FROM {T1} TO {Tsim}
.meas TRAN Tm_avg AVG V(Tmotor) FROM {T1} TO {Tsim}
.meas TRAN Tm_max MAX V(Tmotor) FROM {T1} TO {Tsim}
.meas TRAN Tm_min MIN V(Tmotor) FROM {T1} TO {Tsim}
.meas TRAN IA_rms RMS V(I_A) FROM {T1} TO {Tsim}
.meas TRAN IA_pk MAX abs(V(I_A)) FROM {T1} TO {Tsim}
.meas TRAN rpm_OL AVG V(rpm) FROM 40m TO 50m
.save V(rpm) V(wang) V(tmotor) V(theta) V(theta_t) V(i_a) V(i_b) V(i_c) V(fase_a) V(fase_b) V(fase_c) V(neutral) V(bemfa) V(bemfb) V(bemfc)
.save V(n_virtual_div) V(bemf_a_rec) V(bemf_b_rec) V(bemf_c_rec) V(sensorlessa) V(sensorlessb) V(sensorlessc) V(step) V(estat) V(cnt)
.save V(hai) V(lai) V(hbi) V(lbi) V(hci) V(lci) V(ha_ol) V(la_ol) V(pwm) V(vcc) I(V1) Id(M1) Id(M2)
