PEPpuig/LSE/(list of files, drawings)

Other design files:
Controlador_BLDC/Models/AP1509-50SG-13/Altium/AP1509-50SG-13.SchLib
Controlador_BLDC/Models/AP1509-50SG-13/Altium/SOIC127P600X170-8N.PcbLib
