PEPpuig/LSE/Controlador_BLDC/Controlador_BLDC.kicad_pcb

## KiCad design Controlador_BLDC/Controlador_BLDC.kicad_pcb (2026-10-20)

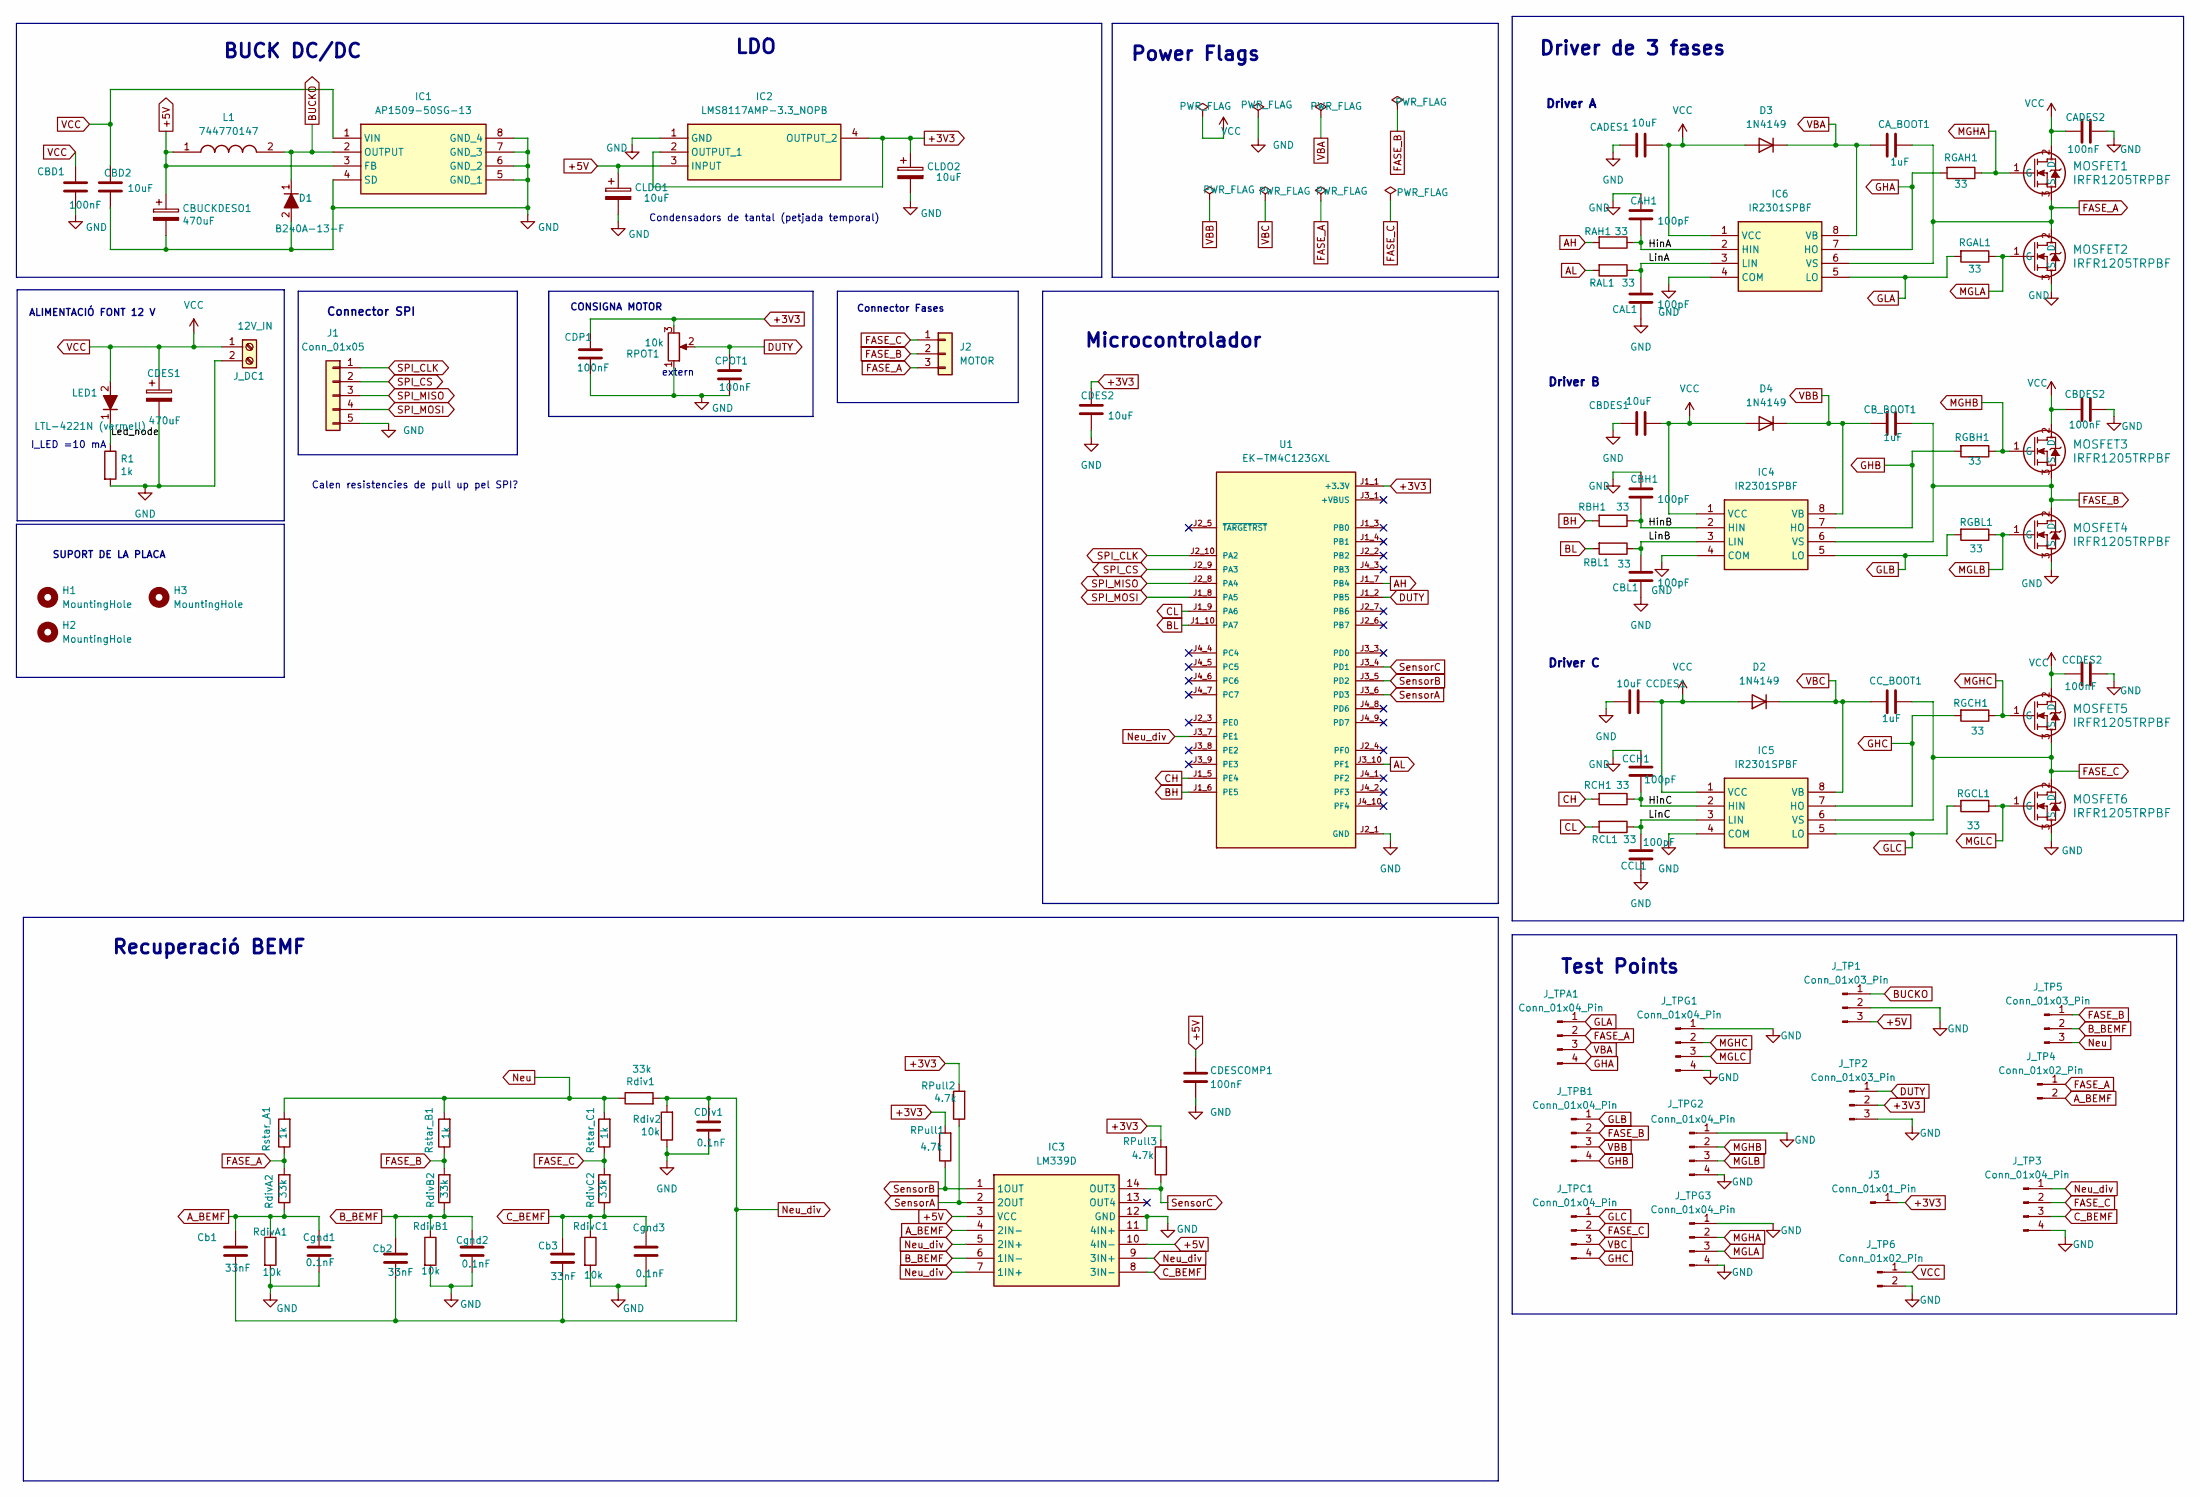
[picture p69: schematic Controlador_BLDC.kicad_sch, Controlador BLDC]

Parts:
CADES1: 10uF; C_1206_3216Metric_Pad1.33x1.80mm_HandSolder
CADES2: 100nF; C_1206_3216Metric_Pad1.33x1.80mm_HandSolder
CAH1: 100pF; C_1206_3216Metric_Pad1.33x1.80mm_HandSolder
CAL1: 100pF; C_1206_3216Metric_Pad1.33x1.80mm_HandSolder
CA_BOOT1: 1uF; C_1206_3216Metric_Pad1.33x1.80mm_HandSolder
CBD1: 100nF; C_1206_3216Metric_Pad1.33x1.80mm_HandSolder
CBD2: 10uF; C_1206_3216Metric_Pad1.33x1.80mm_HandSolder
CBDES1: 10uF; C_1206_3216Metric_Pad1.33x1.80mm_HandSolder
CBDES2: 100nF; C_1206_3216Metric_Pad1.33x1.80mm_HandSolder
CBH1: 100pF; C_1206_3216Metric_Pad1.33x1.80mm_HandSolder
CBL1: 100pF; C_1206_3216Metric_Pad1.33x1.80mm_HandSolder
CBUCKDESO1: 470uF; CP_Elec_10x10.5
CB_BOOT1: 1uF; C_1206_3216Metric_Pad1.33x1.80mm_HandSolder
CCDES1: 10uF; C_1206_3216Metric_Pad1.33x1.80mm_HandSolder
CCDES2: 100nF; C_1206_3216Metric_Pad1.33x1.80mm_HandSolder
CCH1: 100pF; C_1206_3216Metric_Pad1.33x1.80mm_HandSolder
CCL1: 100pF; C_1206_3216Metric_Pad1.33x1.80mm_HandSolder
CC_BOOT1: 1uF; C_1206_3216Metric_Pad1.33x1.80mm_HandSolder
CDES1: 470uF; CP_Elec_10x10.5
CDES2: 10uF; C_1206_3216Metric_Pad1.33x1.80mm_HandSolder
CDESCOMP1: 100nF; C_1206_3216Metric_Pad1.33x1.80mm_HandSolder
CDP1: 100nF; C_1206_3216Metric_Pad1.33x1.80mm_HandSolder
CDiv1: 0.1nF; C_1206_3216Metric_Pad1.33x1.80mm_HandSolder
CLDO1, CLDO2: 10uF; CP_EIA-2012-12_Kemet-R
CPOT1: 100nF; C_1206_3216Metric_Pad1.33x1.80mm_HandSolder
Cb1, Cb2, Cb3: 33nF; C_1206_3216Metric_Pad1.33x1.80mm_HandSolder
Cgnd1, Cgnd2, Cgnd3: 0.1nF; C_1206_3216Metric_Pad1.33x1.80mm_HandSolder
D1: B240A-13-F; DIOM5226X230N; Mouser Part Number 621-B240A-F
D2, D3, D4: 1N4149; D_DO-35_SOD27_P7.62mm_Horizontal
H1, H2, H3: MountingHole; MountingHole_3.2mm_M3
IC1: AP1509-50SG-13; SOIC127P600X170-8N; Manufacturer_Part_Number AP1509-50SG-13; Mouser Part Number 621-AP1509-50SG-13
IC2: LMS8117AMP-3.3_NOPB; SOT230P700X180-4N; Mouser Part Number 926-LMS8117AMP33NOPB
IC3: LM339D; SOIC127P600X175-14N; Mouser Part Number 595-LM339D
IC4, IC5, IC6: IR2301SPBF; SOIC127P600X175-8N; Mouser Part Number 942-IR2301SPBF
J1: Conn_01x05; PinHeader_1x05_P2.54mm_Vertical
J2: MOTOR; TerminalBlock_Phoenix_MKDS-1,5-3-5.08_1x03_P5.08mm_Horizont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
J3: Conn_01x01_Pin; PinHeader_1x01_P2.54mm_Vertical
J_DC1: 12V_IN; TerminalBlock_Phoenix_MKDS-1,5-2-5.08_1x02_P5.08mm_Horizont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
J_TP1, J_TP2, J_TP5: Conn_01x03_Pin; PinHeader_1x03_P2.54mm_Vertical
J_TP3: Conn_01x04_Pin; PinHeader_1x04_P2.54mm_Vertical
J_TP4, J_TP6: Conn_01x02_Pin; PinHeader_1x02_P2.54mm_Vertical
J_TPA1: Conn_01x04_Pin; PinHeader_1x04_P2.54mm_Vertical
J_TPB1: Conn_01x04_Pin; PinHeader_1x04_P2.54mm_Vertical
J_TPC1: Conn_01x04_Pin; PinHeader_1x04_P2.54mm_Vertical
J_TPG1, J_TPG2, J_TPG3: Conn_01x04_Pin; PinHeader_1x04_P2.54mm_Vertical
L1: 744770147; WE-PD_1260_1245_1280_121054; Mouser Part Number 710-744770147
LED1: LTL-4221N (vermell); LTL4221N; Mouser Part Number 859-LTL-4221N
MOSFET1, MOSFET2, MOSFET3, MOSFET4, MOSFET5, MOSFET6: IRFR1205TRPBF; D-PAK_TO-252AA_INF
R1: 1k; R_1206_3216Metric_Pad1.30x1.75mm_HandSolder
RAH1: 33; R_1206_3216Metric_Pad1.30x1.75mm_HandSolder
RAL1: 33; R_1206_3216Metric_Pad1.30x1.75mm_HandSolder
RBH1: 33; R_1206_3216Metric_Pad1.30x1.75mm_HandSolder
RBL1: 33; R_1206_3216Metric_Pad1.30x1.75mm_HandSolder
RCH1: 33; R_1206_3216Metric_Pad1.30x1.75mm_HandSolder
RCL1: 33; R_1206_3216Metric_Pad1.30x1.75mm_HandSolder
RGAH1: 33; R_1206_3216Metric_Pad1.30x1.75mm_HandSolder
RGAL1: 33; R_1206_3216Metric_Pad1.30x1.75mm_HandSolder
RGBH1: 33; R_1206_3216Metric_Pad1.30x1.75mm_HandSolder
RGBL1: 33; R_1206_3216Metric_Pad1.30x1.75mm_HandSolder
RGCH1: 33; R_1206_3216Metric_Pad1.30x1.75mm_HandSolder
RGCL1: 33; R_1206_3216Metric_Pad1.30x1.75mm_HandSolder
RPOT1: 10k; TerminalBlock_Phoenix_MKDS-1,5-3-5.08_1x03_P5.08mm_Horizont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
RPull1, RPull2, RPull3: 4.7k; R_1206_3216Metric_Pad1.30x1.75mm_HandSolder
Rdiv1: 33k; R_1206_3216Metric_Pad1.30x1.75mm_HandSolder
Rdiv2: 10k; R_1206_3216Metric_Pad1.30x1.75mm_HandSolder
RdivA1: 10k; R_1206_3216Metric_Pad1.30x1.75mm_HandSolder
RdivA2: 33k; R_1206_3216Metric_Pad1.30x1.75mm_HandSolder
RdivB1: 10k; R_1206_3216Metric_Pad1.30x1.75mm_HandSolder
RdivB2: 33k; R_1206_3216Metric_Pad1.30x1.75mm_HandSolder
RdivC1: 10k; R_1206_3216Metric_Pad1.30x1.75mm_HandSolder
RdivC2: 33k; R_1206_3216Metric_Pad1.30x1.75mm_HandSolder
Rstar_A1: 1k; R_1206_3216Metric_Pad1.30x1.75mm_HandSolder
Rstar_B1: 1k; R_1206_3216Metric_Pad1.30x1.75mm_HandSolder
Rstar_C1: 1k; R_1206_3216Metric_Pad1.30x1.75mm_HandSolder
U1: EK-TM4C123GXL; MODULE_EK-TM4C123GXL_mofied; PARTREV April 2013

Connections:
+3V3: CDES2.1, CDP1.1, CLDO2.1, IC2.2 (OUTPUT_1), IC2.4 (OUTPUT_2), J3.1, J_TP2.2, RPOT1.3, RPull1.2, RPull2.2, RPull3.2, U1.J1_1 (+3.3V)
+5V: CBUCKDESO1.1, CDESCOMP1.1, CLDO1.1, IC1.3 (FB), IC2.3 (INPUT), IC3.3 (VCC), IC3.10 (4IN-), J_TP1.3, L1.1
/HinA: CAH1.2, IC6.2 (HIN), RAH1.1
/HinB: CBH1.2, IC4.2 (HIN), RBH1.1
/HinC: CCH1.2, IC5.2 (HIN), RCH1.1
/Led_node: LED1.1 (K), R1.1
/LinA: CAL1.1, IC6.3 (LIN), RAL1.1
/LinB: CBL1.1, IC4.3 (LIN), RBL1.1
/LinC: CCL1.1, IC5.3 (LIN), RCL1.1
AH: RAH1.2, U1.J1_7 (PB4)
AL: RAL1.2, U1.J3_10 (PF1)
A_BEMF: Cb1.1, Cgnd1.1, IC3.4 (2IN-), J_TP4.2, RdivA1.1, RdivA2.1
BH: RBH1.2, U1.J1_6 (PE5)
BL: RBL1.2, U1.J1_10 (PA7)
BUCKO: D1.1 (K), IC1.2 (OUTPUT), J_TP1.1, L1.2
B_BEMF: Cb2.1, Cgnd2.1, IC3.6 (1IN-), J_TP5.2, RdivB1.1, RdivB2.1
CH: RCH1.2, U1.J1_5 (PE4)
CL: RCL1.2, U1.J1_9 (PA6)
C_BEMF: Cb3.1, Cgnd3.1, IC3.8 (3IN-), J_TP3.3, RdivC1.1, RdivC2.1
DUTY: CPOT1.1, J_TP2.1, RPOT1.2, U1.J1_2 (PB5)
FASE_A: CA_BOOT1.1, IC6.6 (VS), J2.3, J_TP4.1, J_TPA1.2, MOSFET1.3 (S), MOSFET2.2 (D), RdivA2.2, Rstar_A1.1
FASE_B: CB_BOOT1.1, IC4.6 (VS), J2.2, J_TP5.1, J_TPB1.2, MOSFET3.3 (S), MOSFET4.2 (D), RdivB2.2, Rstar_B1.1
FASE_C: CC_BOOT1.1, IC5.6 (VS), J2.1, J_TP3.2, J_TPC1.2, MOSFET5.3 (S), MOSFET6.2 (D), RdivC2.2, Rstar_C1.1
GHA: IC6.7 (HO), J_TPA1.4, RGAH1.2
GHB: IC4.7 (HO), J_TPB1.4, RGBH1.2
GHC: IC5.7 (HO), J_TPC1.4, RGCH1.2
GLA: IC6.5 (LO), J_TPA1.1, RGAL1.2
GLB: IC4.5 (LO), J_TPB1.1, RGBL1.2
GLC: IC5.5 (LO), J_TPC1.1, RGCL1.2
GND: CADES1.1, CADES2.2, CAH1.1, CAL1.2, CBD1.2, CBD2.2, CBDES1.1, CBDES2.2, CBH1.1, CBL1.2, CBUCKDESO1.2, CCDES1.2, CCDES2.2, CCH1.1, CCL1.2, CDES1.2, CDES2.2, CDESCOMP1.2, CDP1.2, CDiv1.2, CLDO1.2, CLDO2.2, CPOT1.2, Cgnd1.2, Cgnd2.2, Cgnd3.2, D1.2 (A), IC1.4 (SD), IC1.5 (GND_1), IC1.6 (GND_2), IC1.7 (GND_3), IC1.8 (GND_4), IC2.1 (GND), IC3.11 (4IN+), IC3.12 (GND), IC4.4 (COM), IC5.4 (COM), IC6.4 (COM), J1.5, J_DC1.2, J_TP1.2, J_TP2.3, J_TP3.4, J_TP6.2, J_TPG1.1, J_TPG1.4, J_TPG2.1, J_TPG2.4, J_TPG3.1, J_TPG3.4, MOSFET2.3 (S), MOSFET4.3 (S), MOSFET6.3 (S), R1.2, RPOT1.1, Rdiv2.1, RdivA1.2, RdivB1.2, RdivC1.2, U1.J2_1 (GND), U1.J3_2 (GND)
MGHA: J_TPG3.2, MOSFET1.1 (G), RGAH1.1
MGHB: J_TPG2.2, MOSFET3.1 (G), RGBH1.1
MGHC: J_TPG1.2, MOSFET5.1 (G), RGCH1.1
MGLA: J_TPG3.3, MOSFET2.1 (G), RGAL1.1
MGLB: J_TPG2.3, MOSFET4.1 (G), RGBL1.1
MGLC: J_TPG1.3, MOSFET6.1 (G), RGCL1.1
Neu: J_TP5.3, Rdiv1.1, Rstar_A1.2, Rstar_B1.2, Rstar_C1.2
Neu_div: CDiv1.1, Cb1.2, Cb2.2, Cb3.2, IC3.5 (2IN+), IC3.7 (1IN+), IC3.9 (3IN+), J_TP3.1, Rdiv1.2, Rdiv2.2, U1.J3_7 (PE1)
SPI_CLK: J1.1, U1.J2_10 (PA2)
SPI_CS: J1.2, U1.J2_9 (PA3)
SPI_MISO: J1.3, U1.J2_8 (PA4)
SPI_MOSI: J1.4, U1.J1_8 (PA5)
SensorA: IC3.2 (2OUT), RPull2.1, U1.J3_6 (PD3)
SensorB: IC3.1 (1OUT), RPull1.1, U1.J3_5 (PD2)
SensorC: IC3.14 (OUT3), RPull3.1, U1.J3_4 (PD1)
VBA: CA_BOOT1.2, D3.1 (K), IC6.8 (VB), J_TPA1.3
VBB: CB_BOOT1.2, D4.1 (K), IC4.8 (VB), J_TPB1.3
VBC: CC_BOOT1.2, D2.1 (K), IC5.8 (VB), J_TPC1.3
VCC: CADES1.2, CADES2.1, CBD1.1, CBD2.1, CBDES1.2, CBDES2.1, CCDES1.1, CCDES2.1, CDES1.1, D2.2 (A), D3.2 (A), D4.2 (A), IC1.1 (VIN), IC4.1 (VCC), IC5.1 (VCC), IC6.1 (VCC), J_DC1.1, J_TP6.1, LED1.2 (A), MOSFET1.2 (D), MOSFET3.2 (D), MOSFET5.2 (D)

Notes on the sheet:
I_LED =10 mA
Driver C
BUCK DC/DC
LDO
Calen resistencies de pull up pel SPI?
Connector Fases
Condensadors de tantal (petjada temporal)
Test Points
Driver de 3 fases
Driver A
Connector SPI
Recuperació BEMF
Driver B
Microcontrolador
ALIMENTACIÓ FONT 12 V
CONSIGNA MOTOR
extern
Power Flags
SUPORT DE LA PLACA

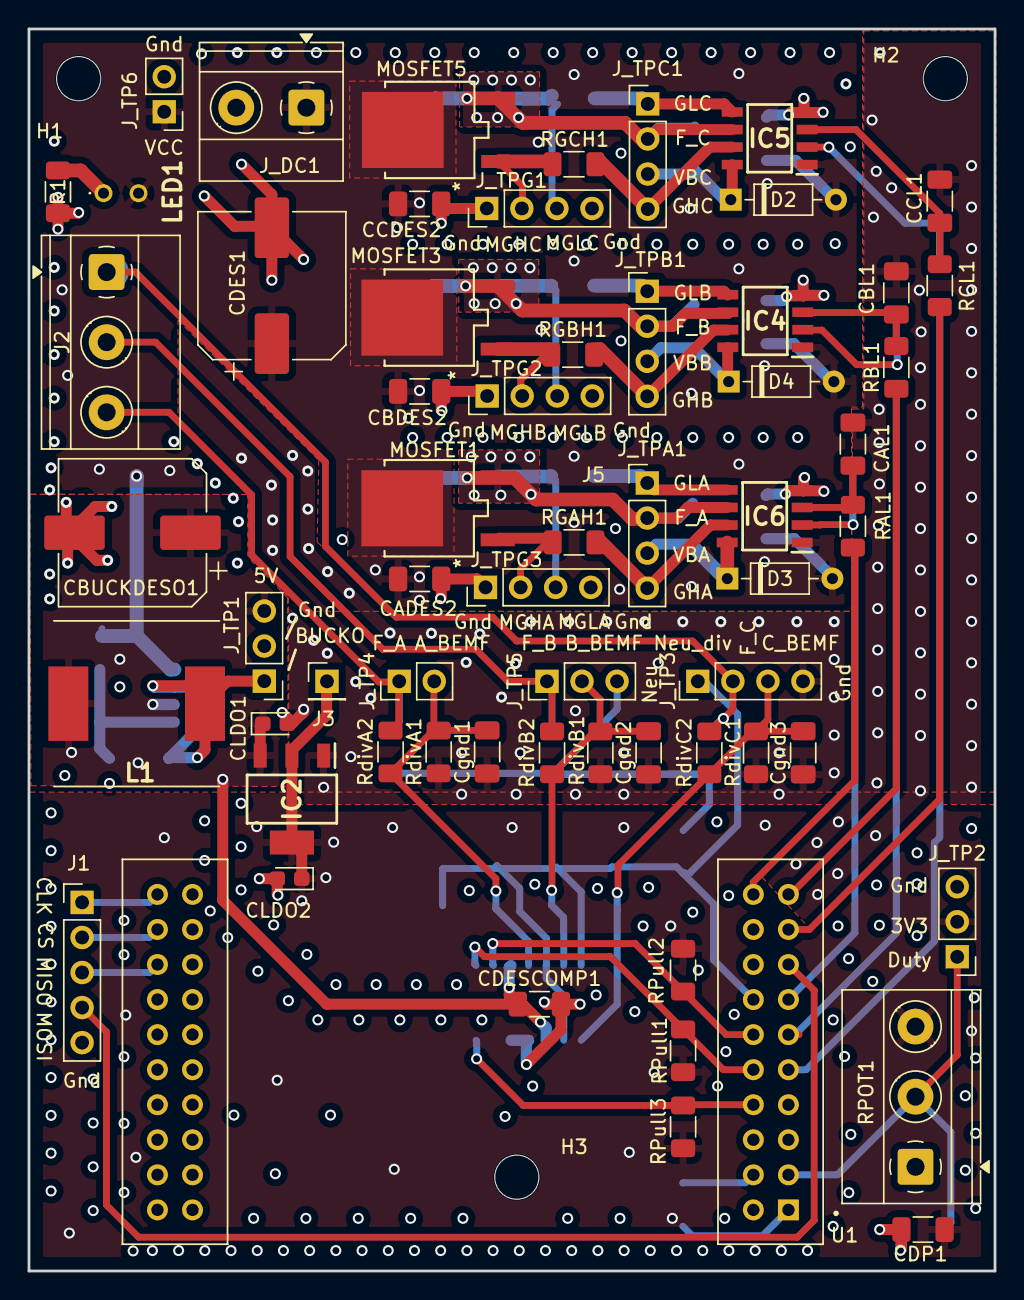
[picture p70: board Controlador_BLDC.kicad_pcb from above]

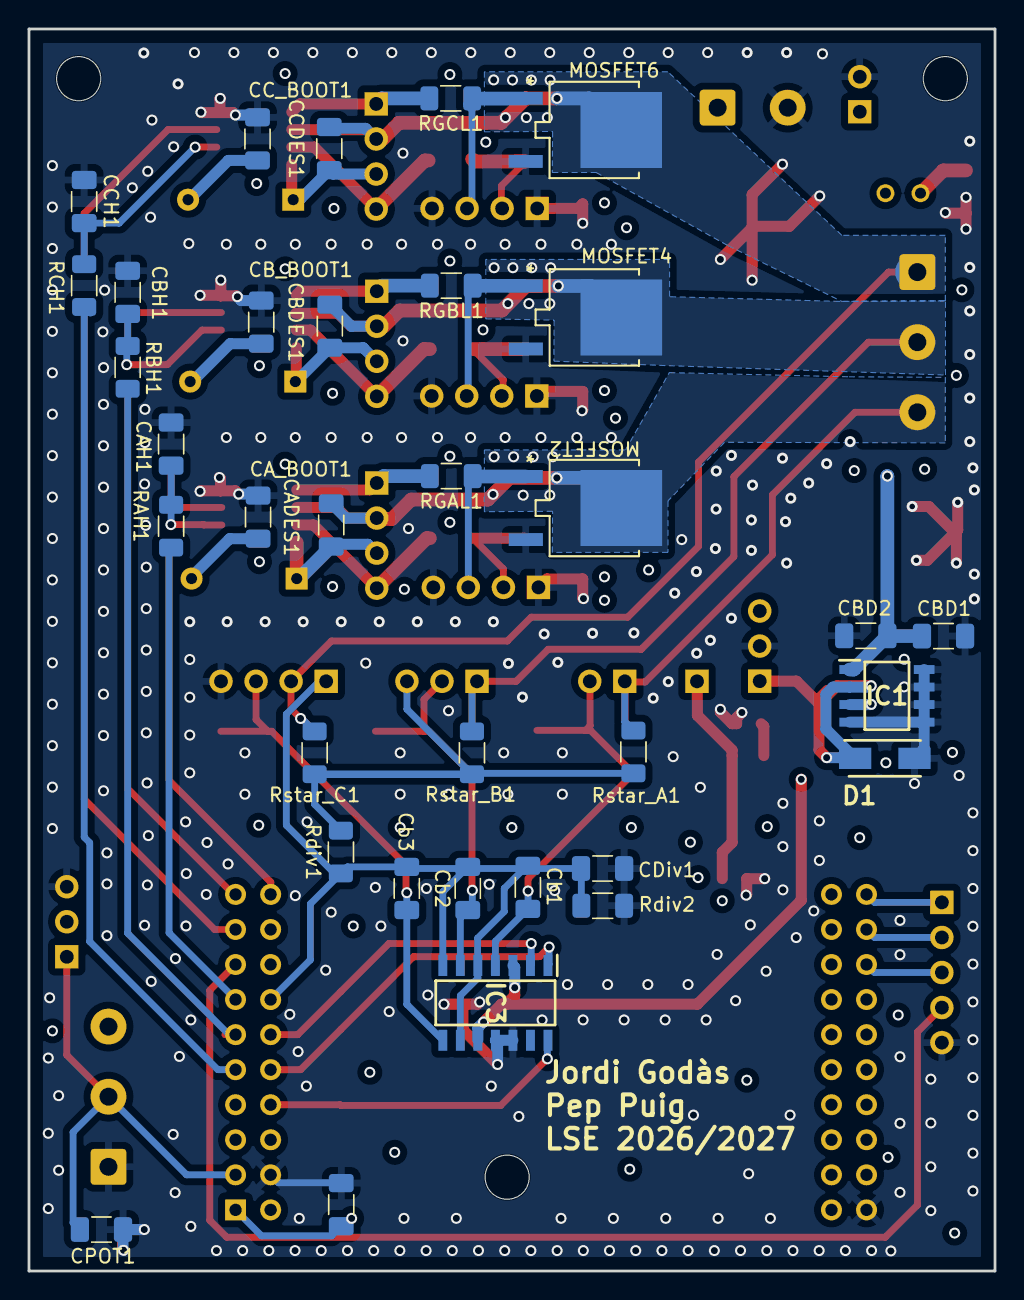
[picture p71: board Controlador_BLDC.kicad_pcb from below]

Board: 4 copper layers, 70.0 x 90.0 mm, 98 parts (34 on the bottom side), 49 nets.
