PEPpuig/LSE/(commit log)

2026-09-23 Primer esquematic
    [1468345.stp, Controlador_BLDC.kicad_pcb, Controlador_BLDC.kicad_sch]
2026-09-23 Kicad despres de classe
    [Controlador_BLDC.kicad_sch]
2026-09-28 Entrada de potencia, noves petjades
    [AP63201WU-7.stp, Controlador_BLDC.kicad_sch]
2026-09-30 Primer intent de deteccio BEMF, canvis en entrada de potencia
2026-10-01 Acabat general de la placa (falta revisar)
    [1468345.stp, AP63201WU-7.stp, Controlador_BLDC.kicad_pcb, Controlador_BLDC.kicad_sch]
2026-10-05 Delete fp-info-cache
    mal colocat els poso al fitxer de controlador bldc
2026-10-05 Delete Controlador_BLDC.kicad_sch
    Moure a Controlador_BLDC
    [Controlador_BLDC.kicad_sch]
2026-10-05 Delete Controlador_BLDC.kicad_pro
    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
2026-10-05 Delete Controlador_BLDC.kicad_pcb
    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
    [Controlador_BLDC.kicad_pcb]
2026-10-05 Moure a Controlador_BLDC
    [1468345.stp, AP63201WU-7.stp]
2026-10-05 Esquematic semi acabat
    Falta els valors de resistencies de calcul BEMF, ja que no son E6. S'ha: colocat la petjada a tots els components, arreglat els errors de ERC, calculat valors de L, C i diode de shotkky pel BUCK, solucionat error de footprints del ldo, nous models importats en el segënt commit
    [Controlador_BLDC.kicad_sch]
2026-10-05 Actualitzacio dels Models
    S'ha afegti la petjada modificada pel potenciometre, arreglada la footprint del LDO, diode shotkey i bobina smd
2026-10-05 Models actualitzats
    S'a afegit model editat pel potenciometre, arreglat el model del LDO, i nous models de diode de shotkey i bobina smd també pel buck
2026-10-05 Models acabats
    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
2026-10-08 Revisió de la placa de PepPuig
2026-10-11 Acceptació de la revisió de Pep Puig a la placa de Jordi Godas
    S'afegeix el pdf i el propi word
2026-10-14 Versió final* de la placa
    S'ha canviat la recuperacio BEMF del esquematic, testpoints, i s'ha millorat tots els errors de la pcb
2026-10-15 Entrega per enviar a fabricar
    Inclou la placa acabada, els gerbers per fabricació i el llistat del material
2026-10-15 Entrega de la placa a fabricar
    Inclou la placa acabada , els gerbers, i el llistat del material
2026-10-15 Versió definitiva de la placa
    S'ha fet una revisió de la placa i s'ha canviatt models i disseny en general. És la placa que s'ha enviat a fabricar
2026-10-20 Versió final**
    S'ha corretgit el problema de DRC indicat pel profesor a les capes de coure a les fases
2026-10-20 Versió definitva**
    Versio acabada enviada pel correu al professorat de l'assignatura
2026-10-20 Gerbers de la placa enviats a fabricar
2026-10-27 Reordenat de blocs
2026-11-12 3ra entrega de l'informe
